0xmeowmeow/braidbench/social/industrial-poster.png

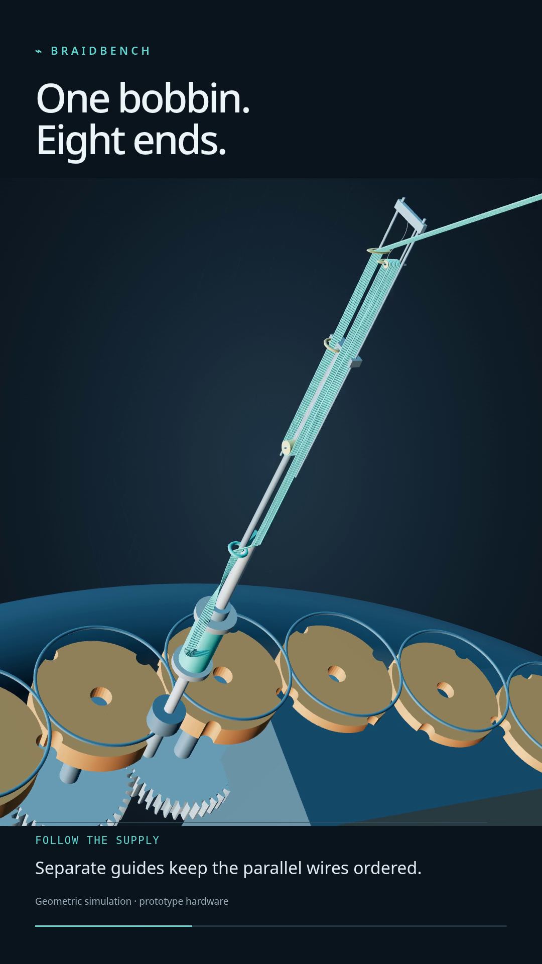
social/industrial-poster.png
