0xmeowmeow/braidbench/previews/braid-cutaway-72.png

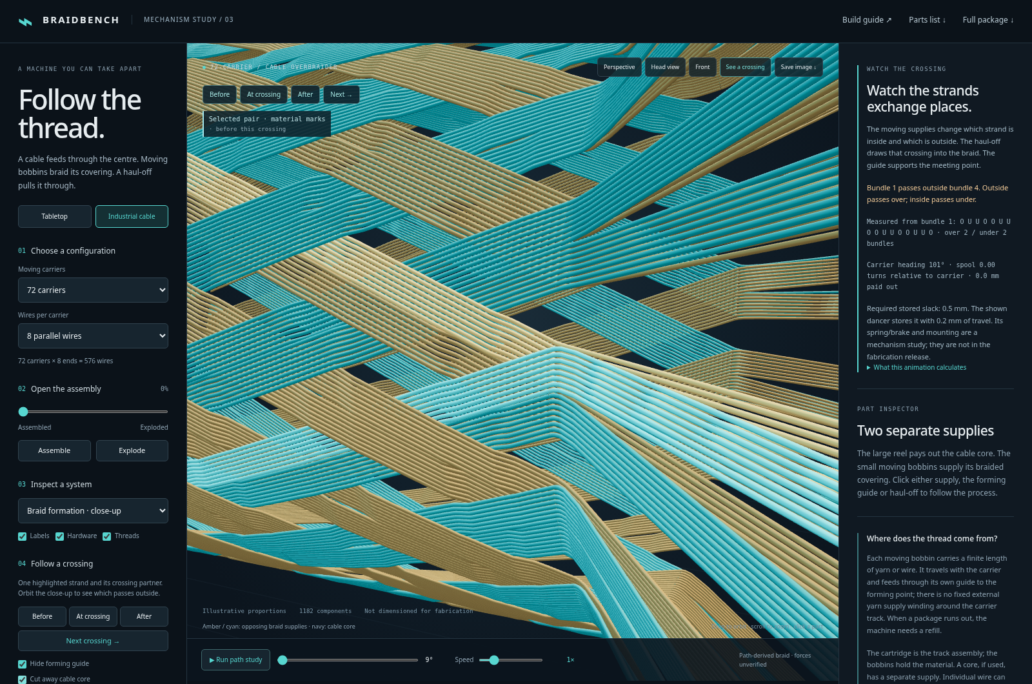
previews/braid-cutaway-72.png
