0xmeowmeow/braidbench/previews/bobbin-close-8.png

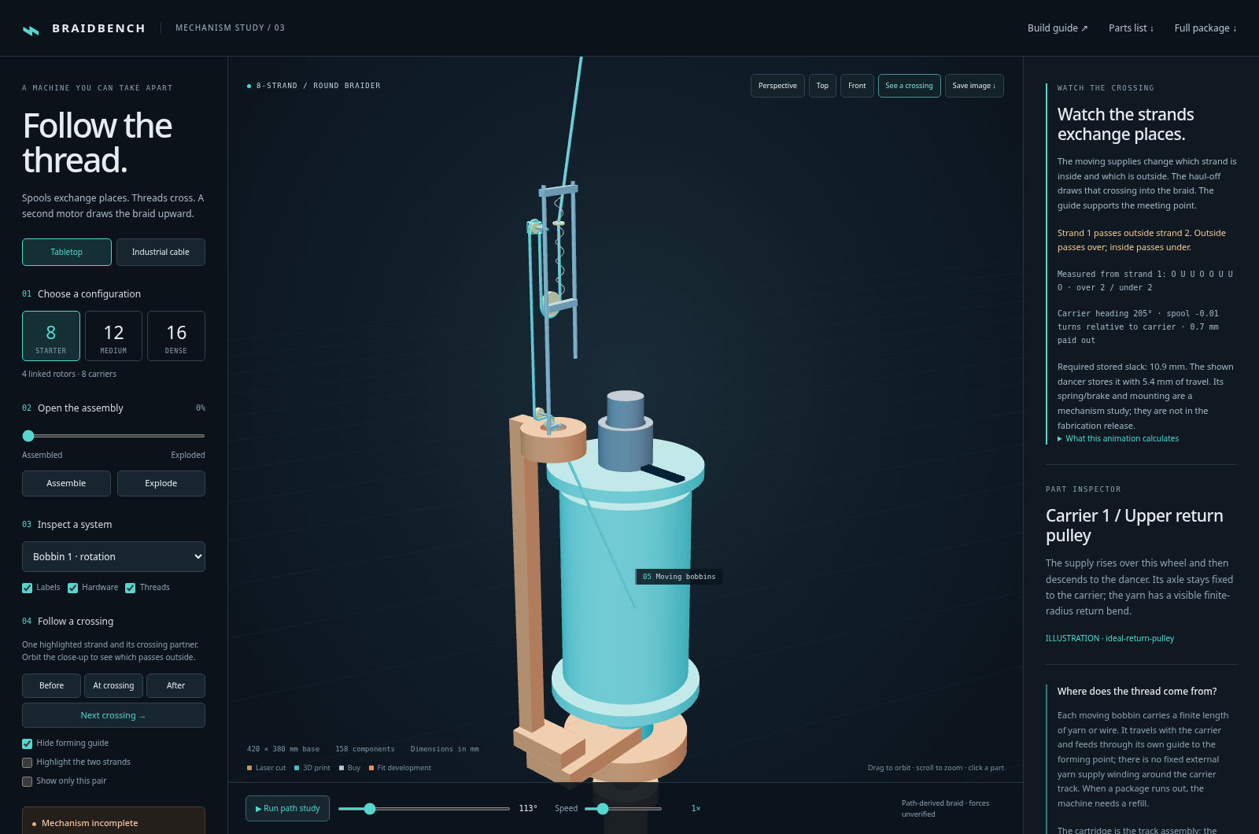
previews/bobbin-close-8.png
