0xmeowmeow/braidbench/previews/bobbin-close-16.png

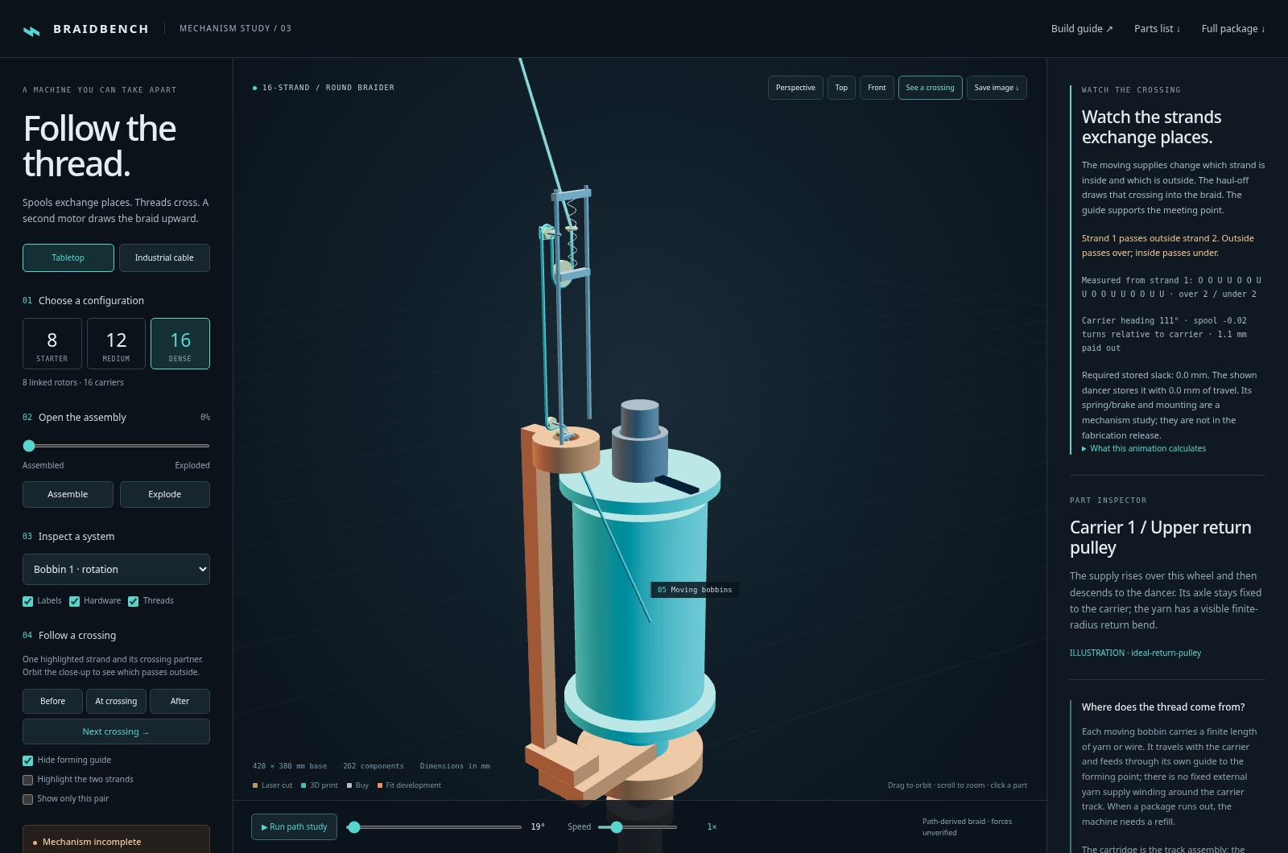
previews/bobbin-close-16.png
