0xmeowmeow/braidbench/previews/bobbin-close-48.png

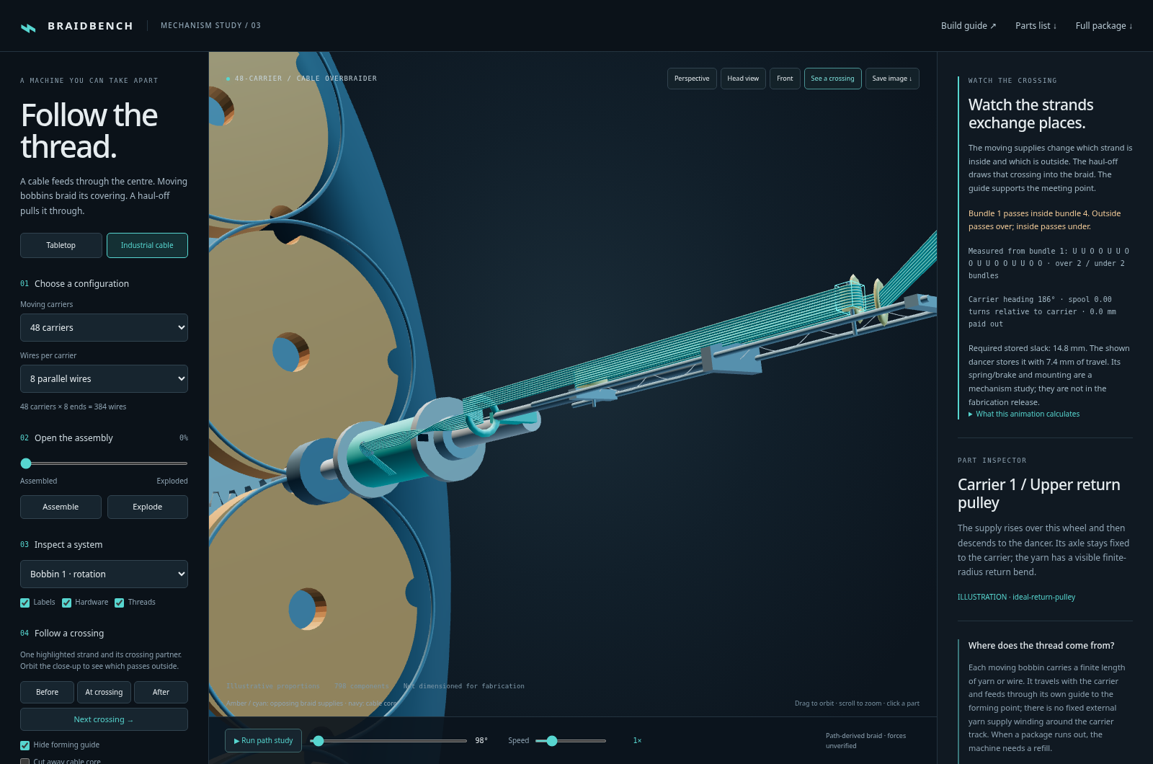
previews/bobbin-close-48.png
