0xmeowmeow/braidbench/previews/bobbin-close-72.png

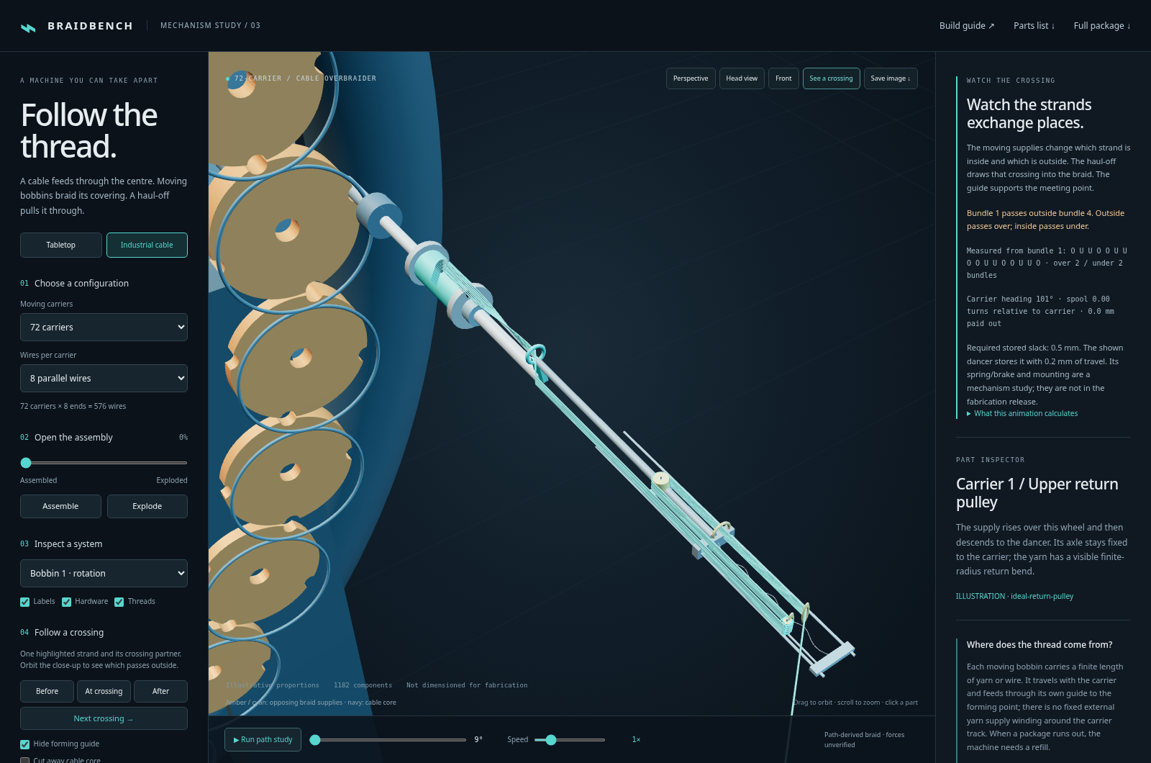
previews/bobbin-close-72.png
