0xmeowmeow/braidbench/previews/bobbin-tension.png

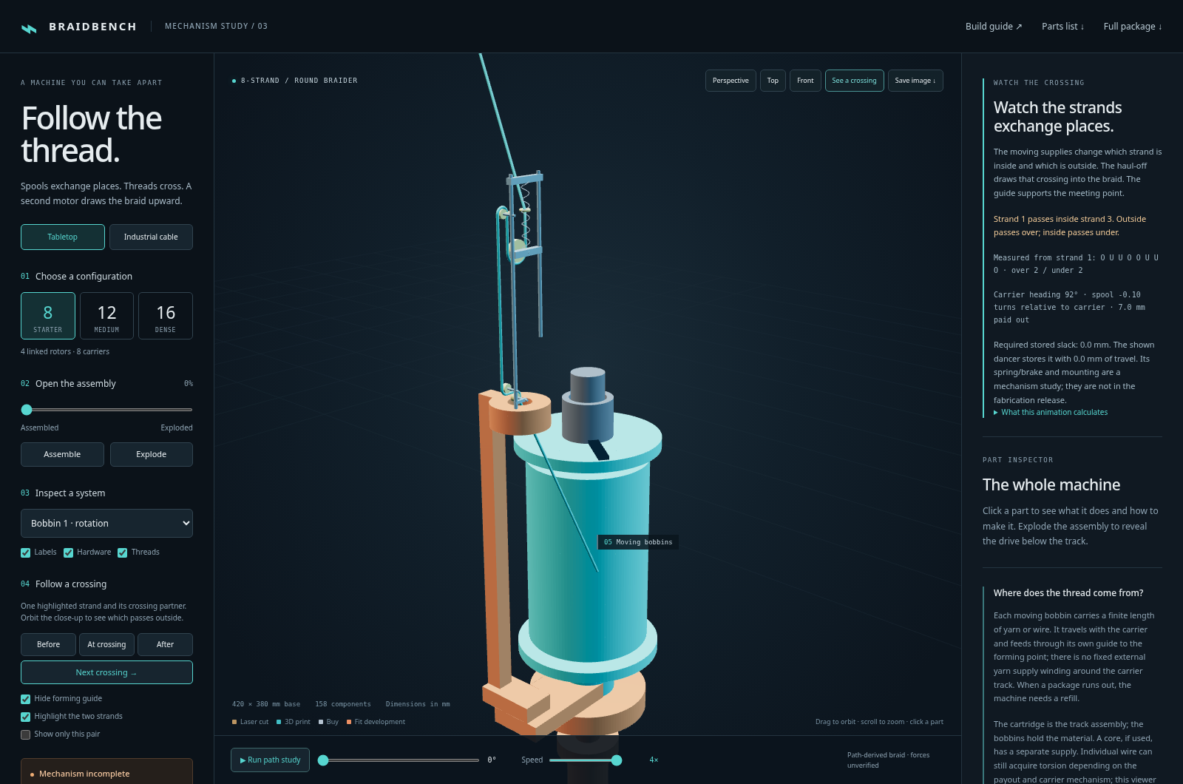
previews/bobbin-tension.png
