0xmeowmeow/braidbench/previews/braid-close-8.png

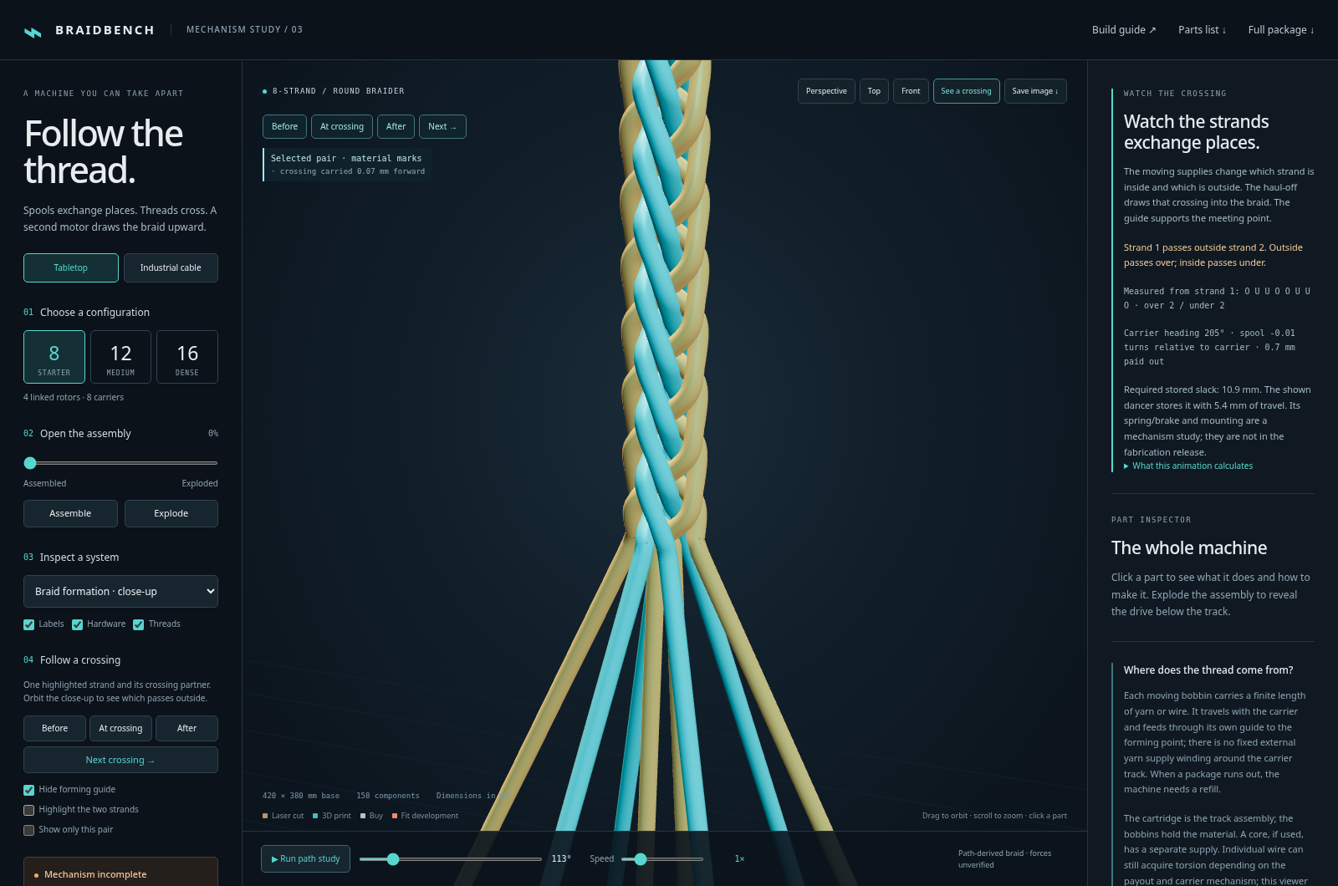
previews/braid-close-8.png
