0xmeowmeow/braidbench/previews/braid-close-16.png

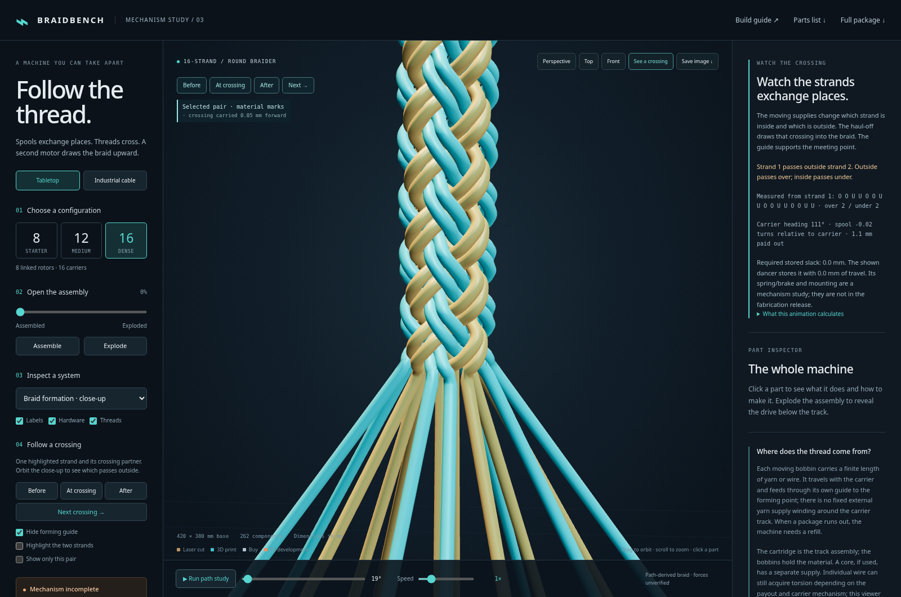
previews/braid-close-16.png
