0xmeowmeow/braidbench/previews/braid-close-48.png

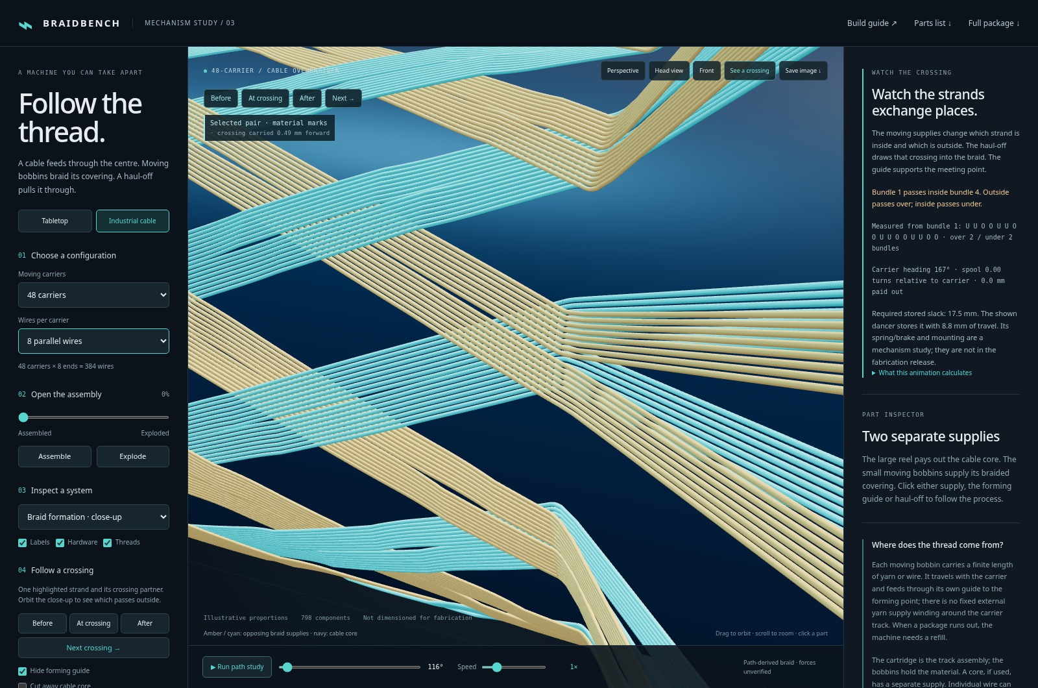
previews/braid-close-48.png
