0xmeowmeow/braidbench/previews/braid-close-72.png

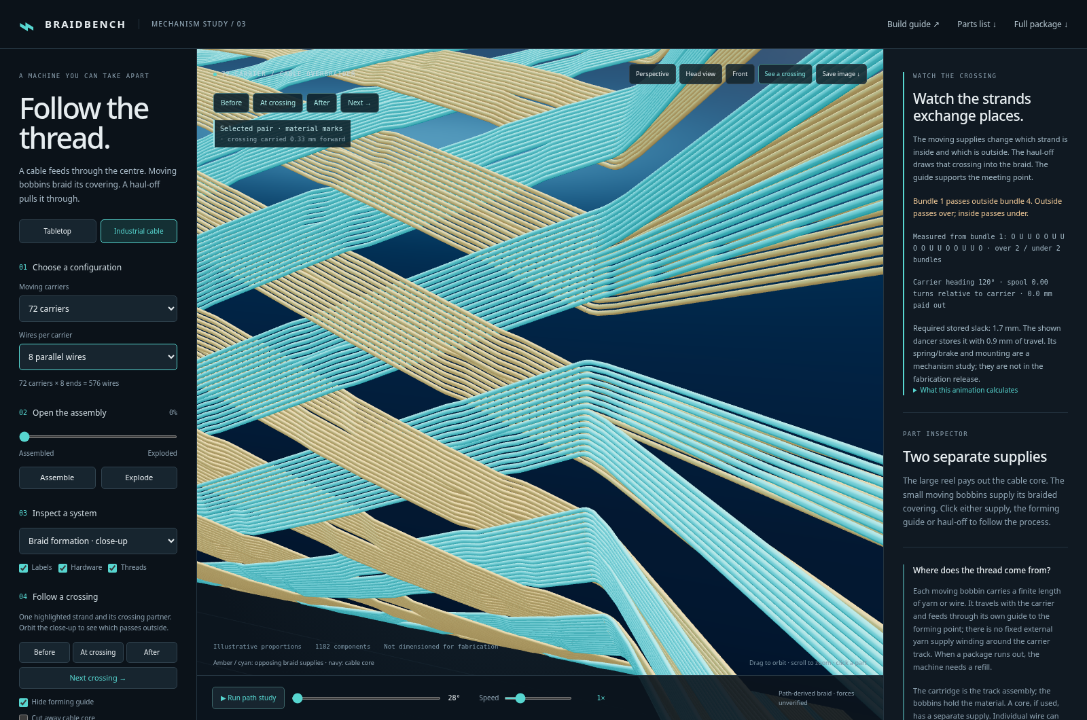
previews/braid-close-72.png
