0xmeowmeow/braidbench/previews/braid-cutaway-48.png

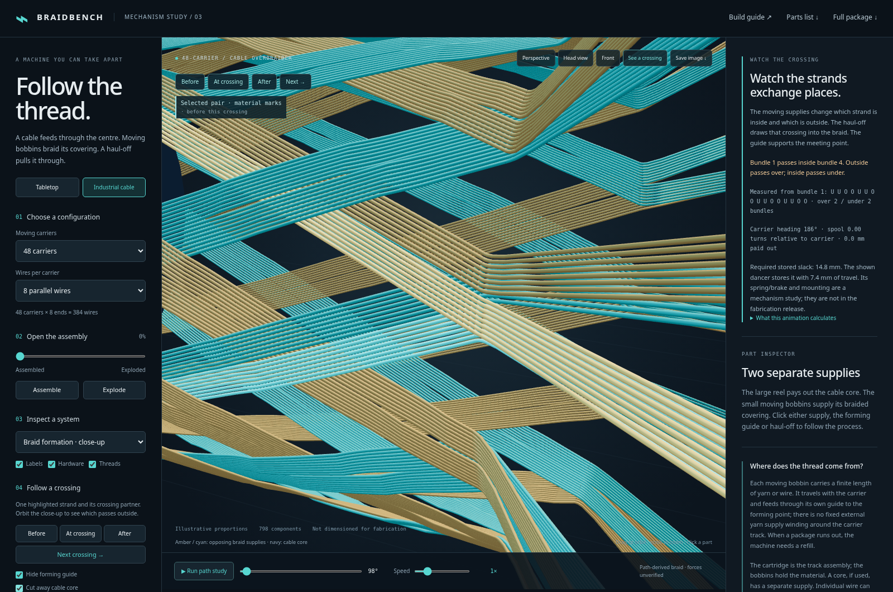
previews/braid-cutaway-48.png
