0xmeowmeow/braidbench/previews/drive.png

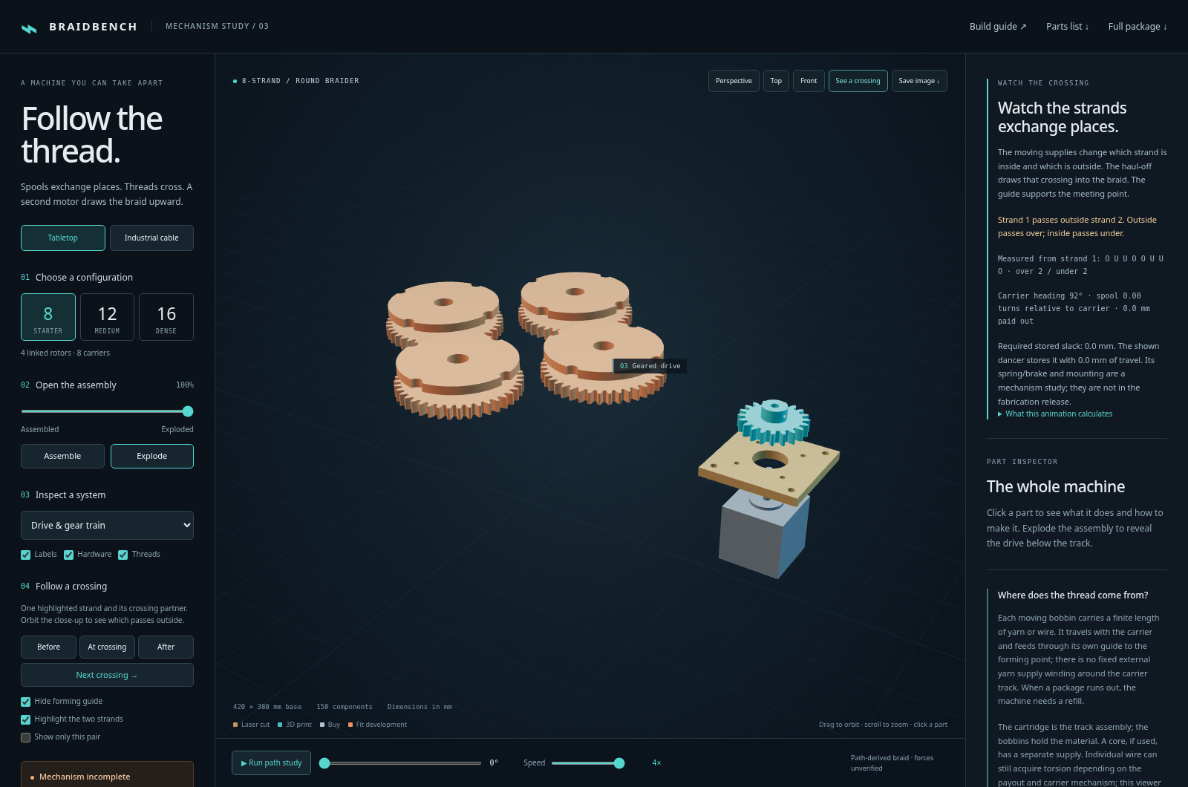
previews/drive.png
