0xmeowmeow/braidbench/previews/exploded.png

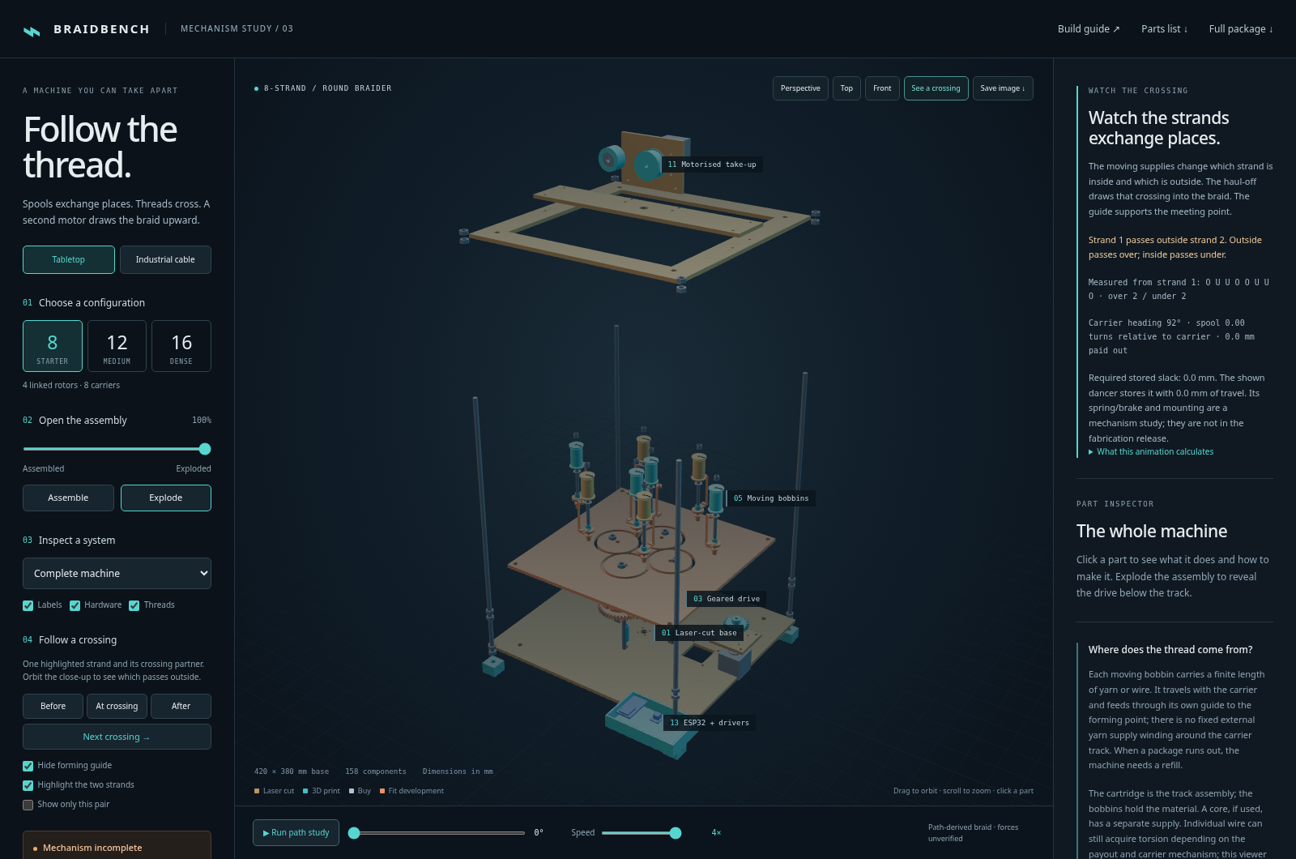
previews/exploded.png
