0xmeowmeow/braidbench/previews/formation-industrial-all.png

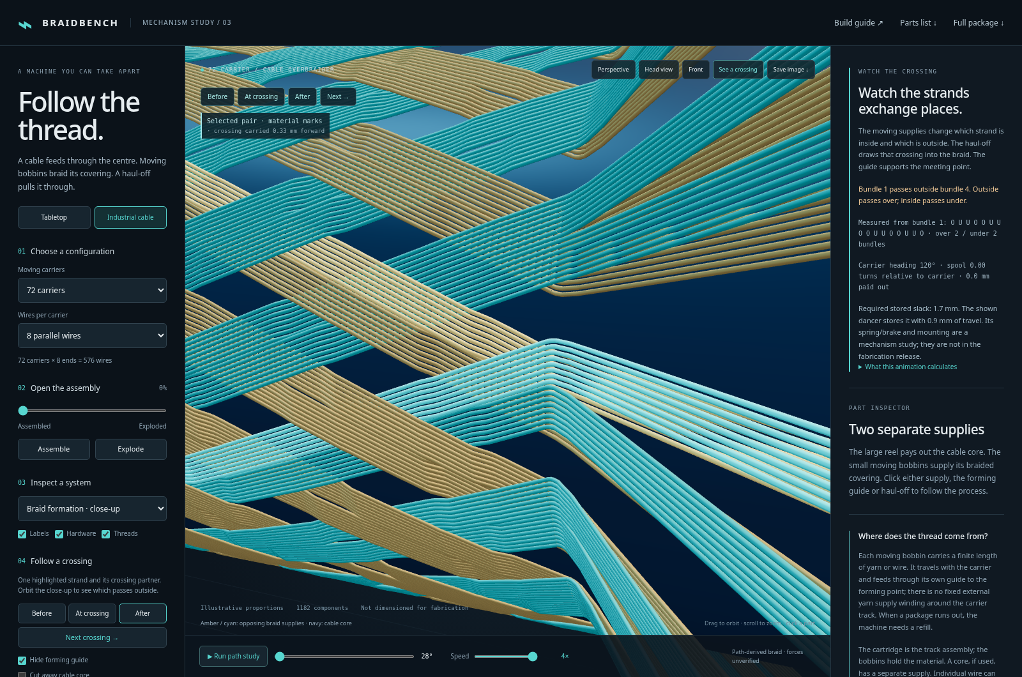
previews/formation-industrial-all.png
