0xmeowmeow/braidbench/previews/formation-industrial.png

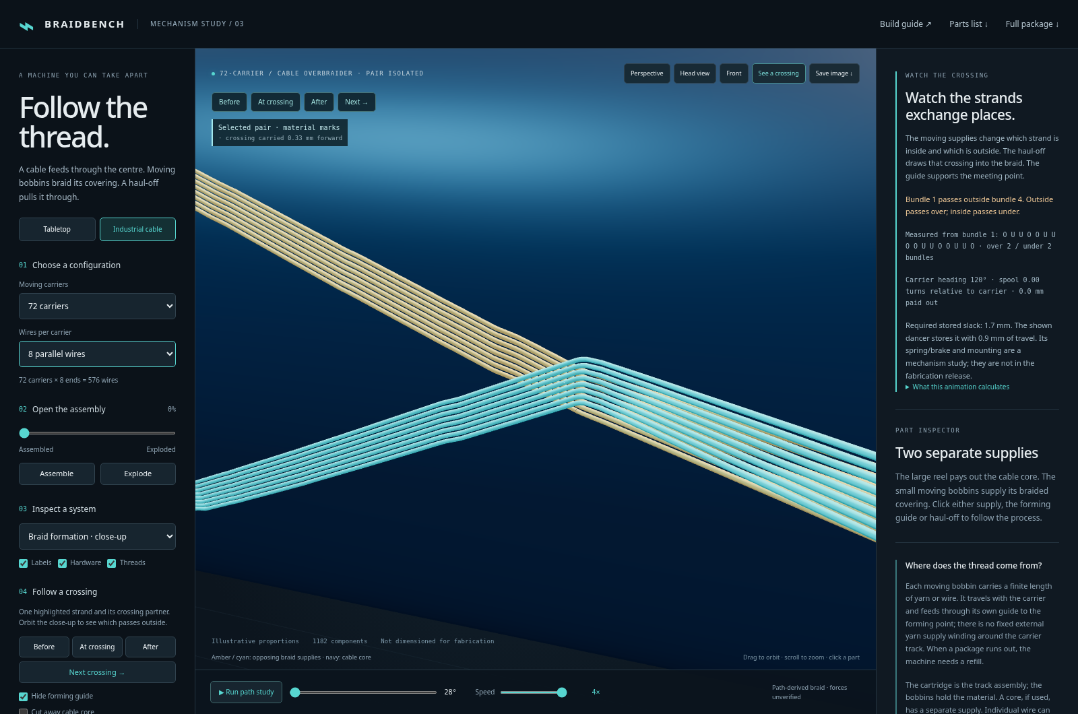
previews/formation-industrial.png
