0xmeowmeow/braidbench/previews/formation-mobile-320.png

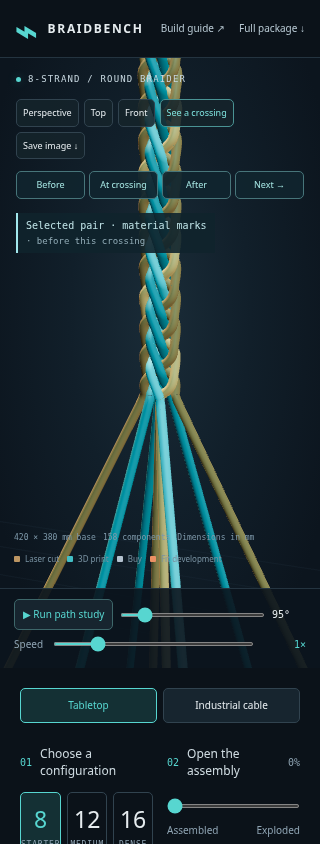
previews/formation-mobile-320.png
