0xmeowmeow/braidbench/previews/formation-mobile-390.png

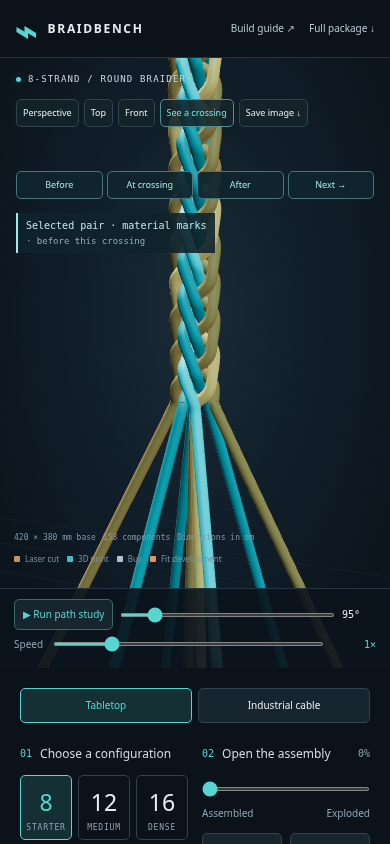
previews/formation-mobile-390.png
