0xmeowmeow/braidbench/previews/industrial-bobbin.png

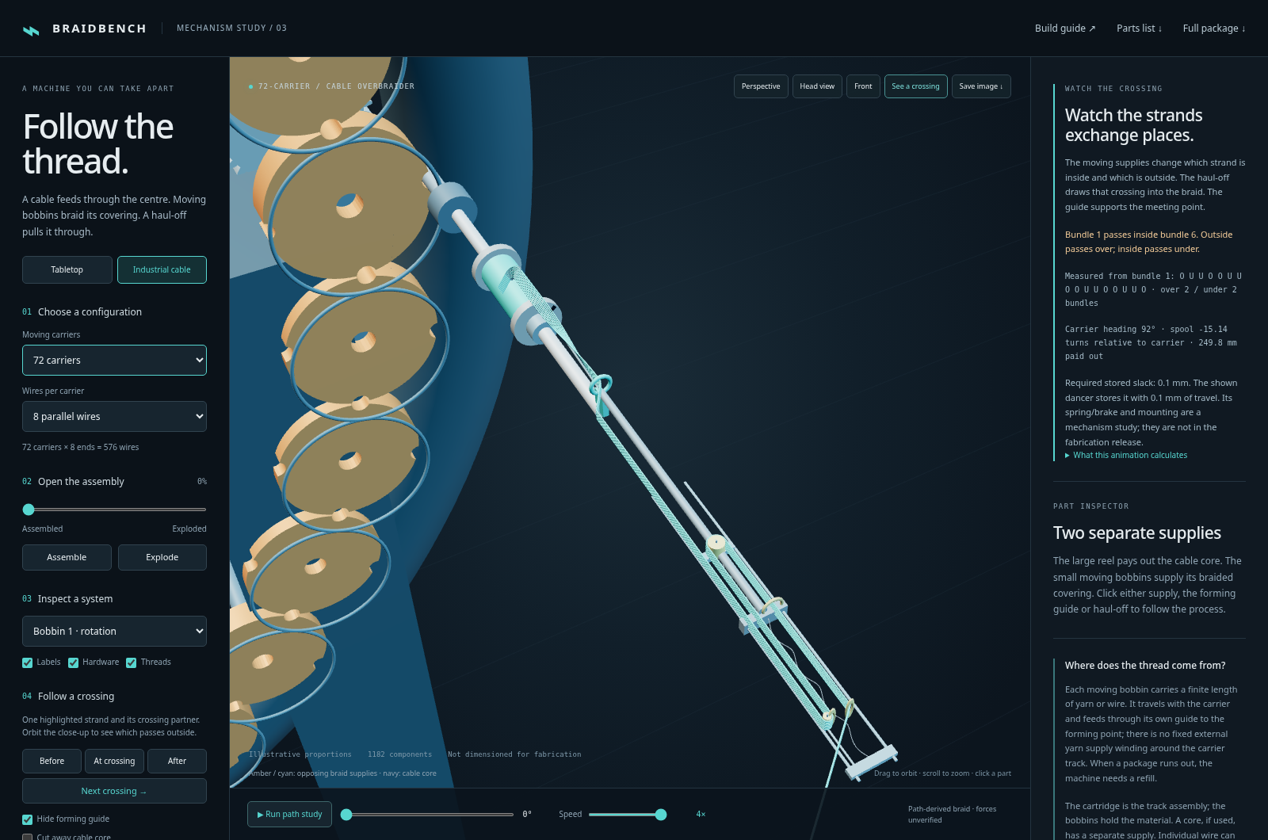
previews/industrial-bobbin.png
