0xmeowmeow/braidbench/previews/industrial-exploded.png

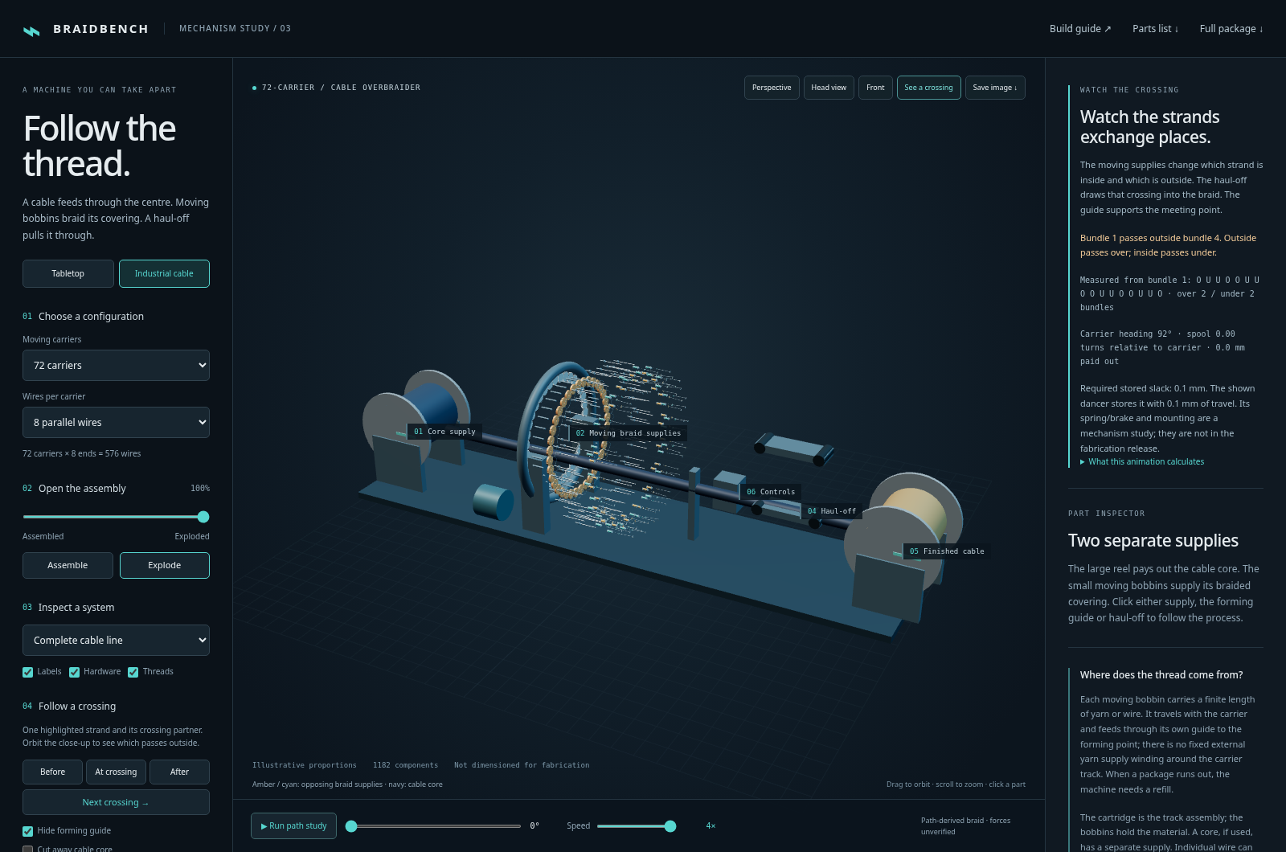
previews/industrial-exploded.png
