0xmeowmeow/braidbench/previews/industrial-head.png

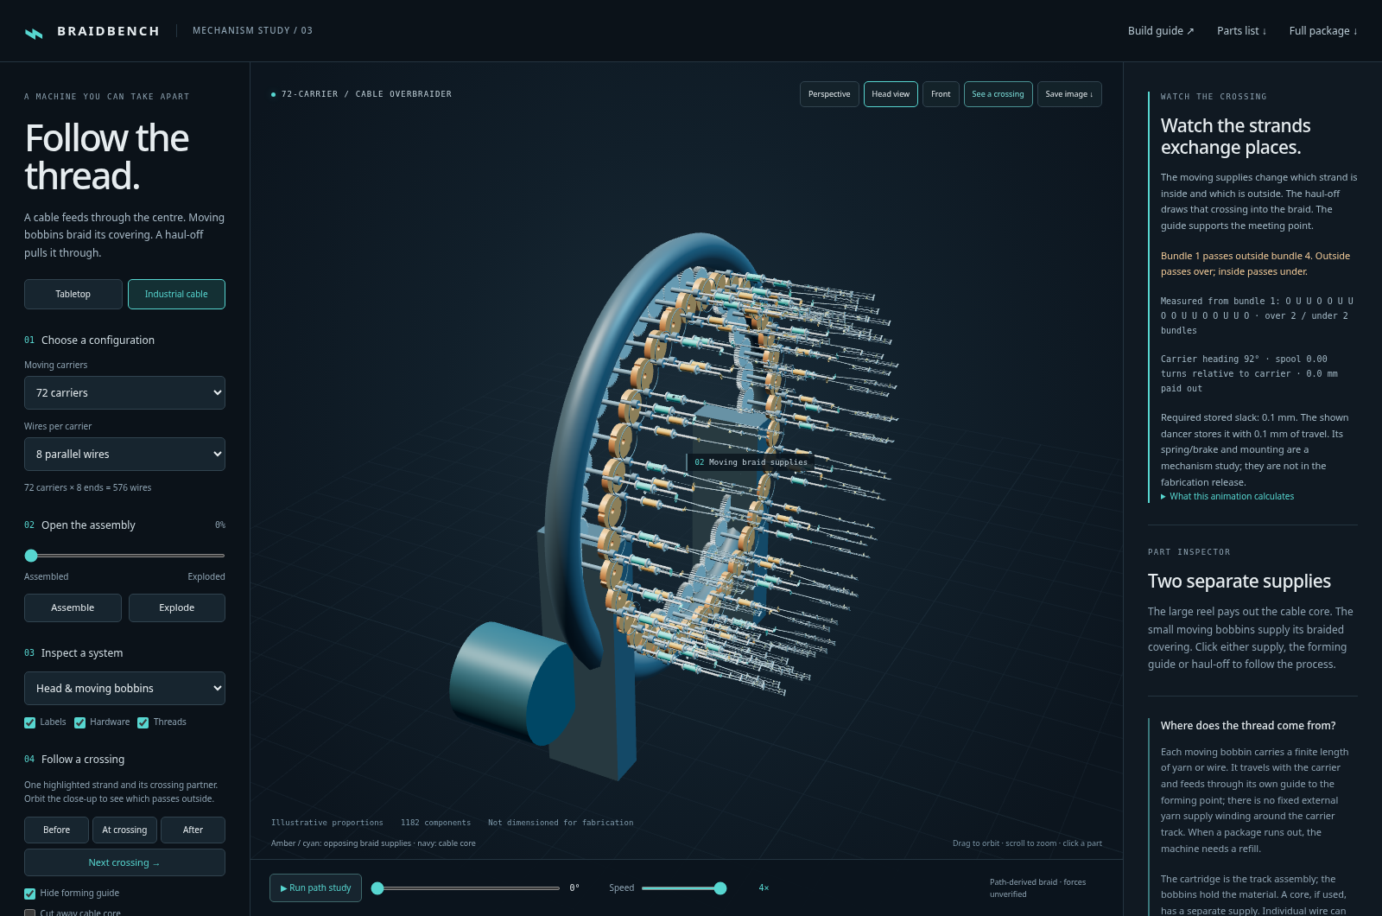
previews/industrial-head.png
