0xmeowmeow/braidbench/previews/industrial-mobile-320.png

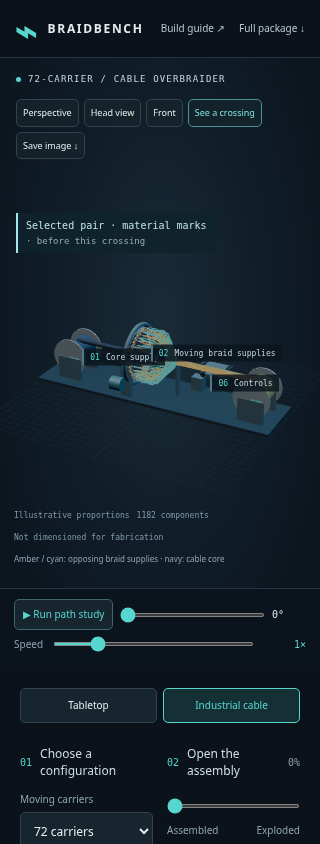
previews/industrial-mobile-320.png
