0xmeowmeow/braidbench/previews/industrial-mobile.png

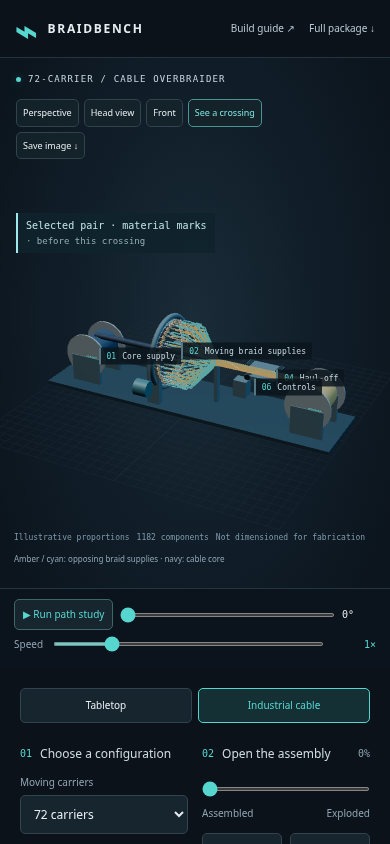
previews/industrial-mobile.png
