0xmeowmeow/braidbench/previews/industrial.png

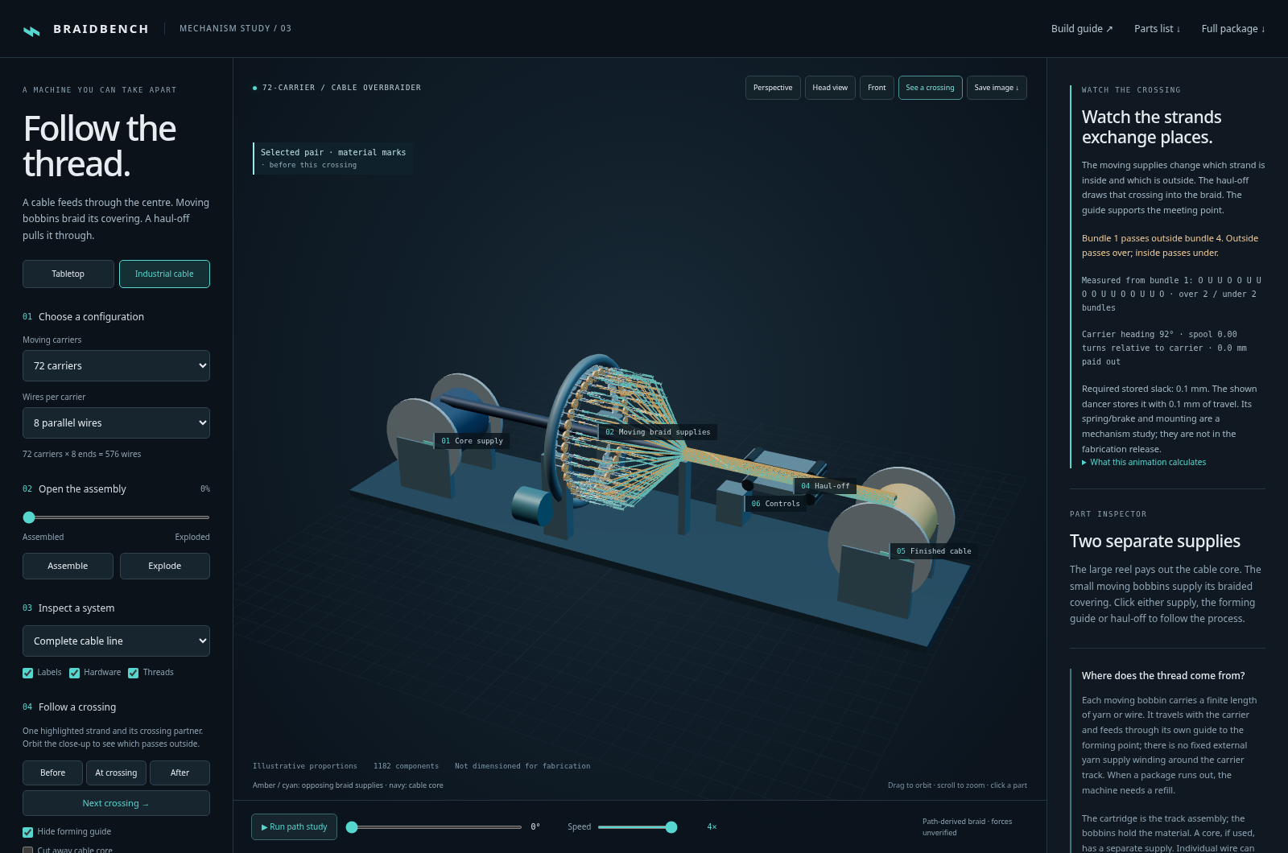
previews/industrial.png
