0xmeowmeow/braidbench/previews/mobile.png

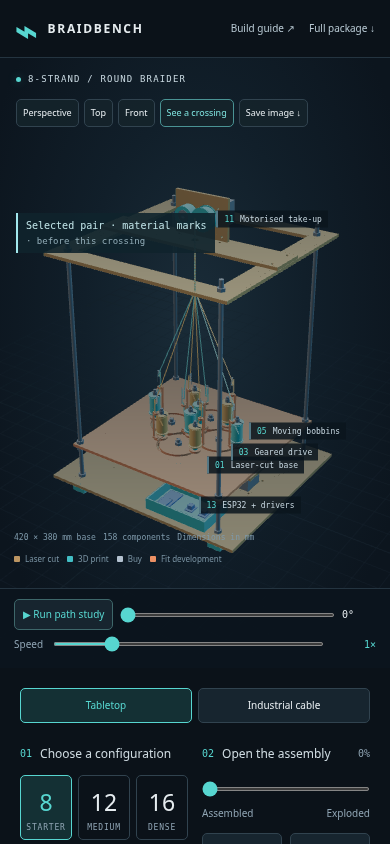
previews/mobile.png
