0xmeowmeow/braidbench/previews/publication-home-live.png

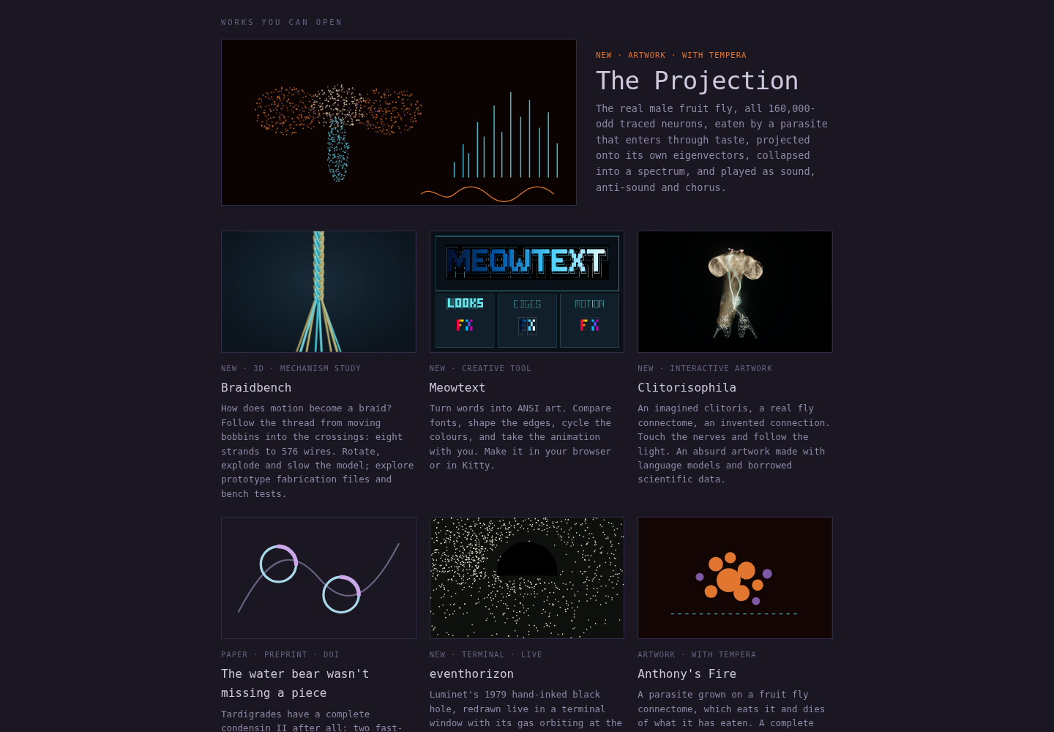
previews/publication-home-live.png
