0xmeowmeow/braidbench/previews/publication-home-mobile.png

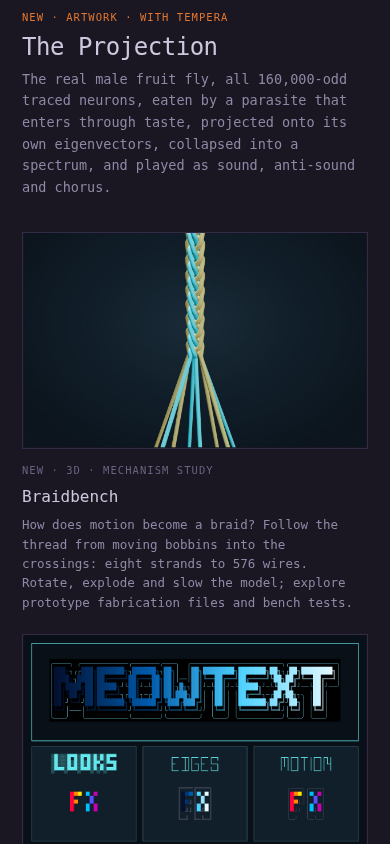
previews/publication-home-mobile.png
