0xmeowmeow/braidbench/previews/publication-model-live.png

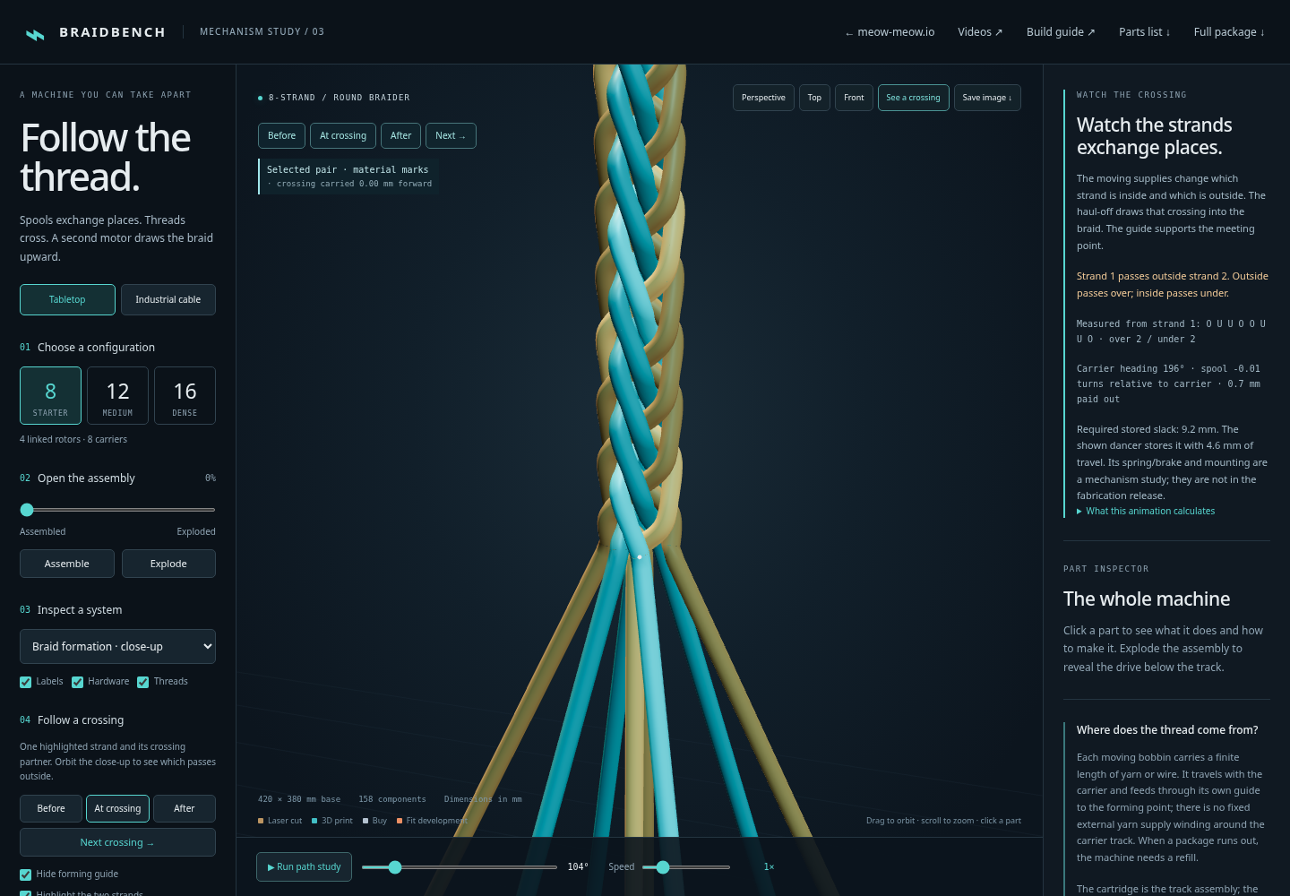
previews/publication-model-live.png
