0xmeowmeow/braidbench/previews/publication-videos-mobile.png

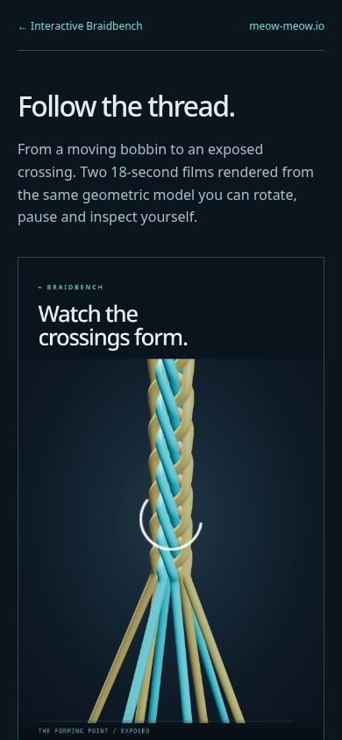
previews/publication-videos-mobile.png
