0xmeowmeow/braidbench/previews/tension-board.png

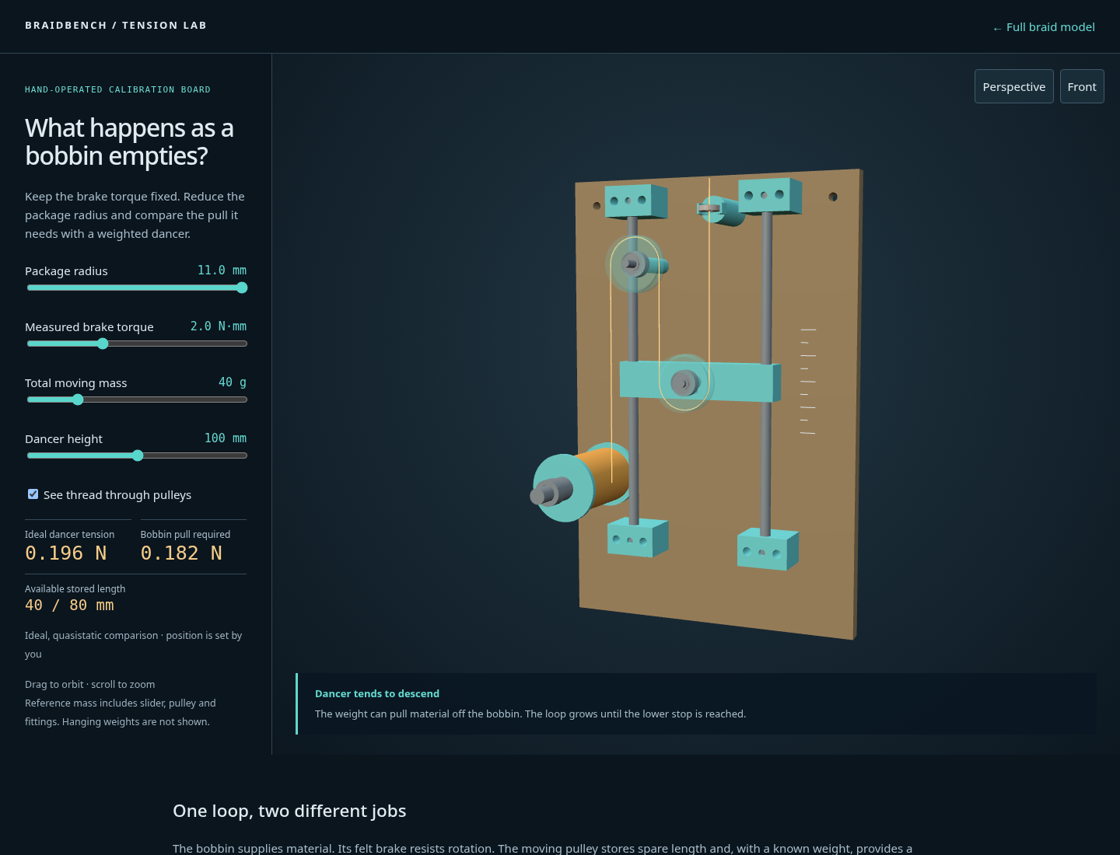
previews/tension-board.png
