0xmeowmeow/braidbench/previews/tension-mobile.png

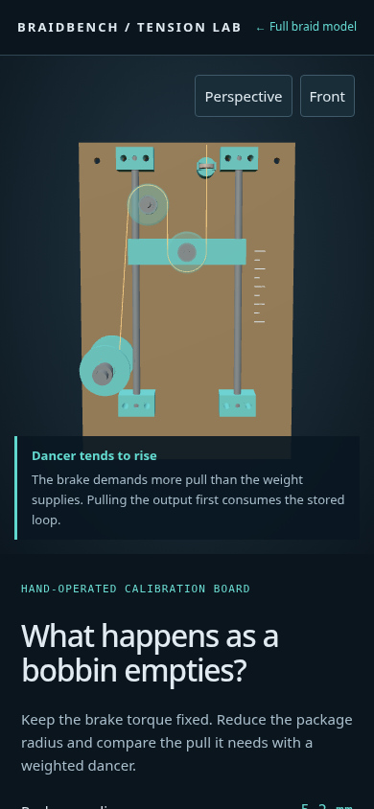
previews/tension-mobile.png
