0xmeowmeow/braidbench/previews/transfer-mobile.png

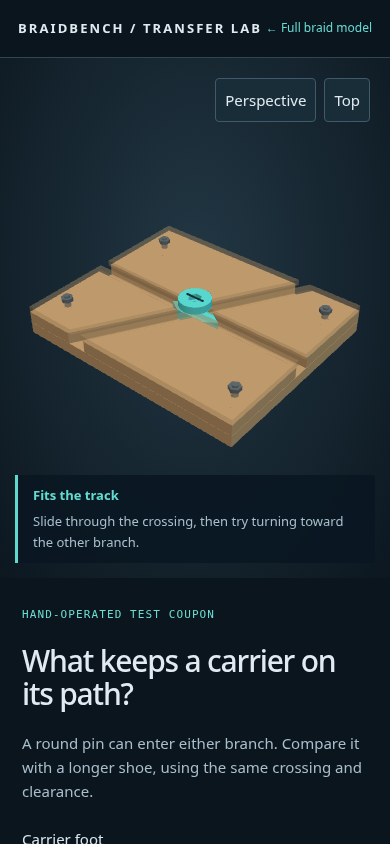
previews/transfer-mobile.png
