0xmeowmeow/braidbench/previews/transfer-round.png

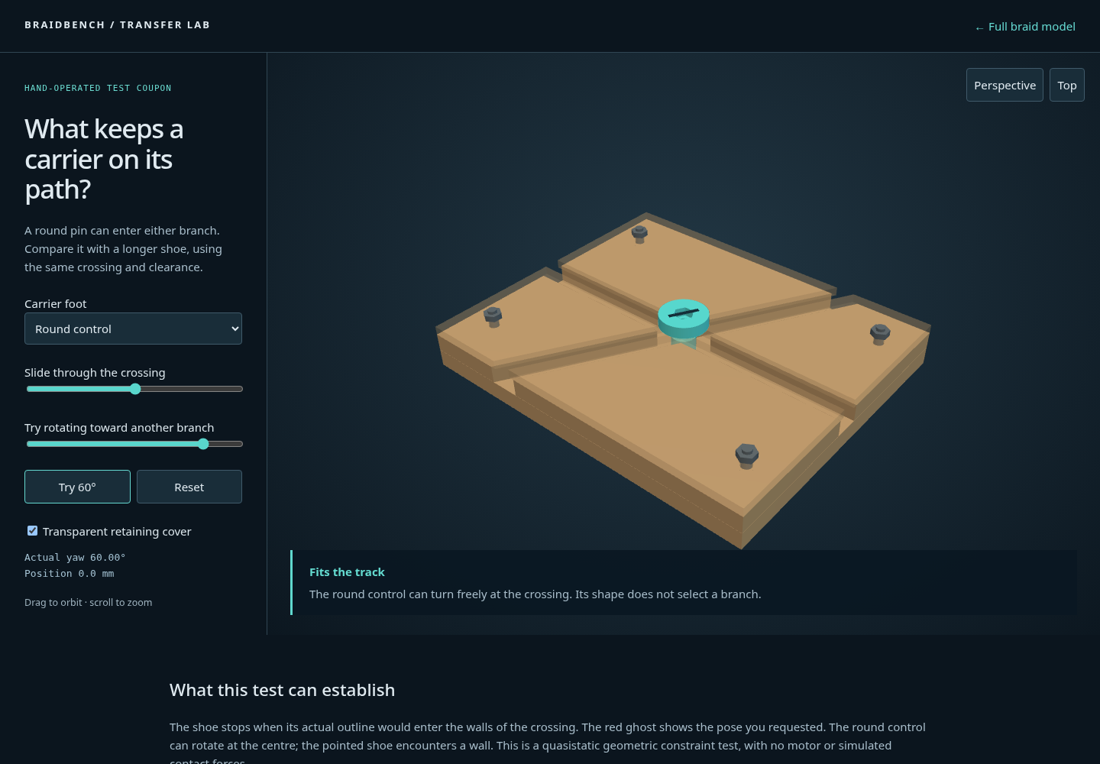
previews/transfer-round.png
