0xmeowmeow/braidbench/share/braidbench.jpg

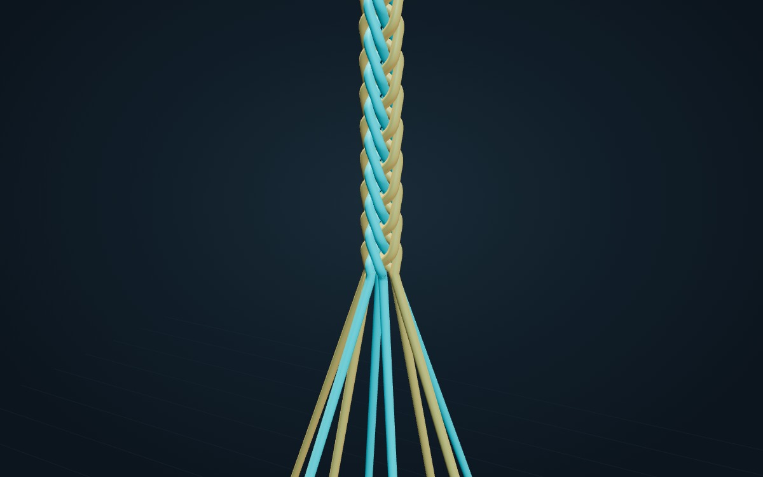
share/braidbench.jpg
