0xmeowmeow/braidbench/social/tabletop-poster.png

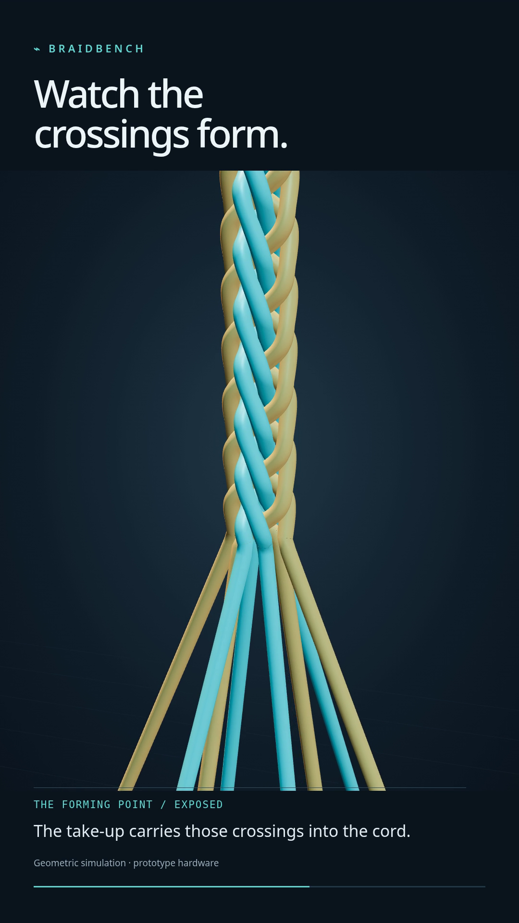
social/tabletop-poster.png
