0xmeowmeow/braidbench/fabrication/experiments/transfer/boat-shoe.step

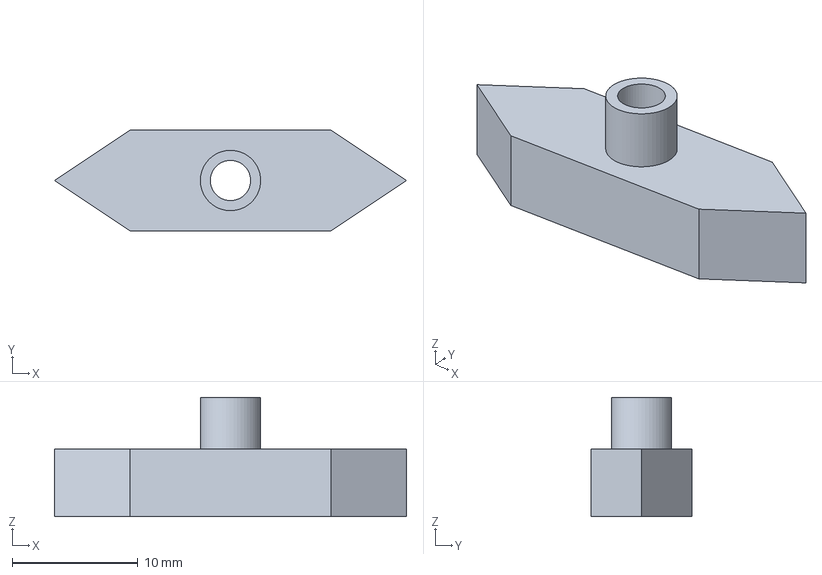
[picture p37: CAD file, 2026-10-12]
fabrication/experiments/transfer/boat-shoe.step
28.0 x 8.00 x 9.50 mm
