0xmeowmeow/braidbench/fabrication/laser/track-study-8.dxf

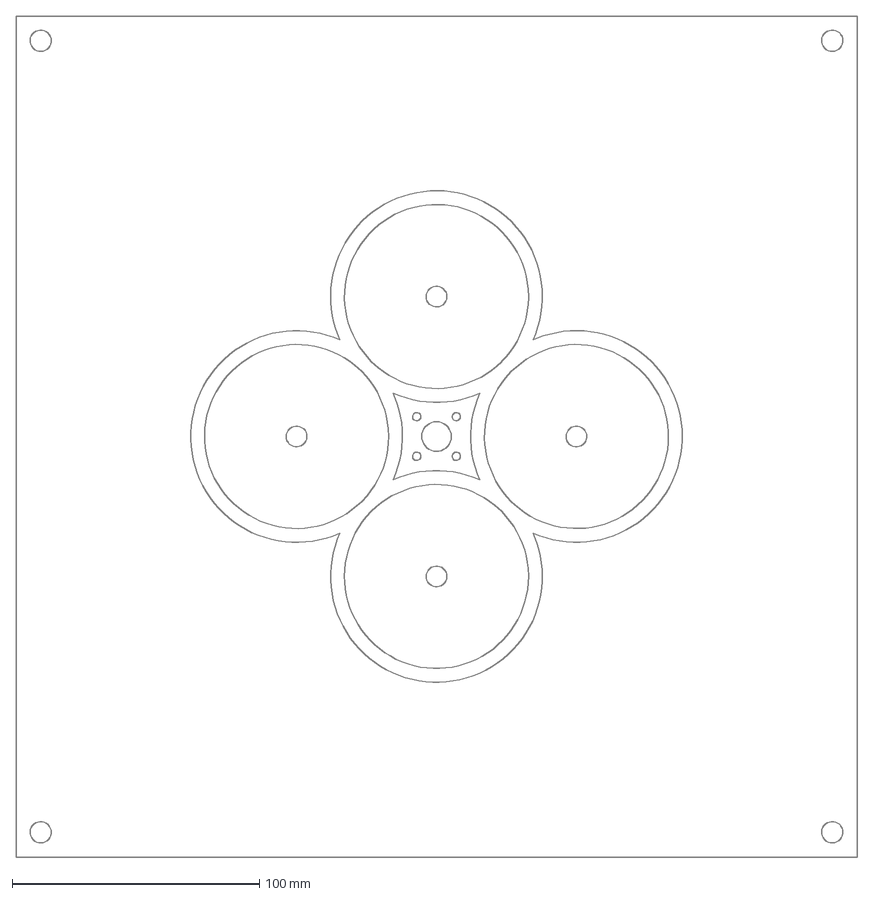
[picture p38: CAD file, 2026-10-12]
fabrication/laser/track-study-8.dxf
340.0 x 340.0 mm
