0xmeowmeow/braidbench/fabrication/printed/rotor-8-01.step

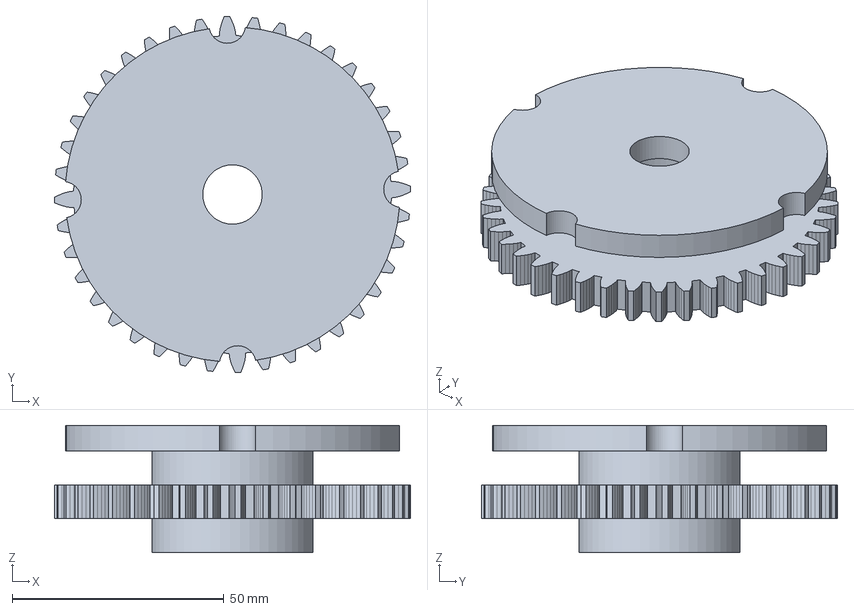
[picture p39: CAD file, 2026-10-12]
fabrication/printed/rotor-8-01.step
84.0 x 84.0 x 30.0 mm
