0xmeowmeow/braidbench/cad/braidbench-12.step

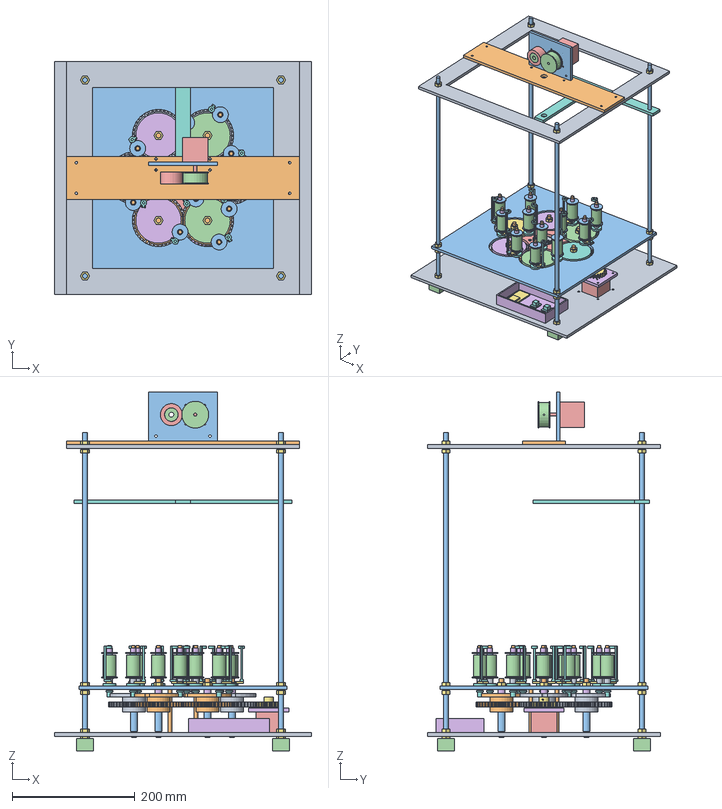
[picture p40: CAD file, 2026-10-12]
cad/braidbench-12.step
420.0 x 380.0 x 586.0 mm
