0xmeowmeow/braidbench/fabrication/experiments/tension/bobbin-base.step

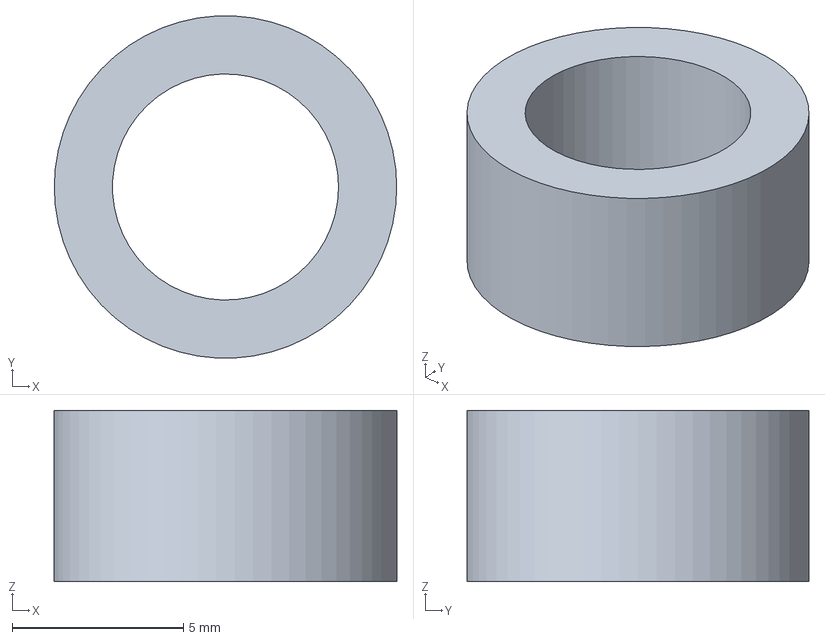
[picture p41: CAD file, 2026-10-12]
fabrication/experiments/tension/bobbin-base.step
10.0 x 9.99 x 5.00 mm
