0xmeowmeow/braidbench/fabrication/experiments/transfer/transfer-coupon.step

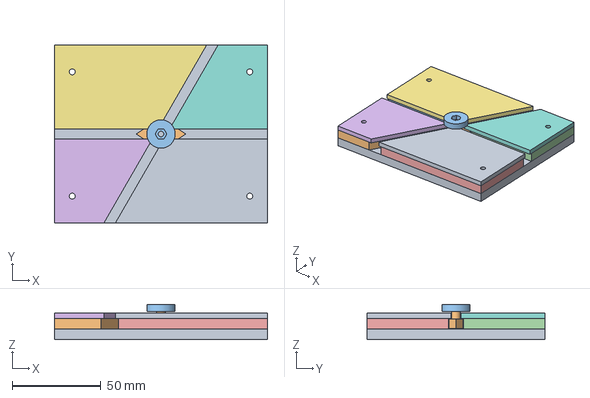
[picture p42: CAD file, 2026-10-12]
fabrication/experiments/transfer/transfer-coupon.step
120.0 x 100.0 x 19.8 mm
