0xmeowmeow/braidbench/fabrication/laser/takeup-face.dxf

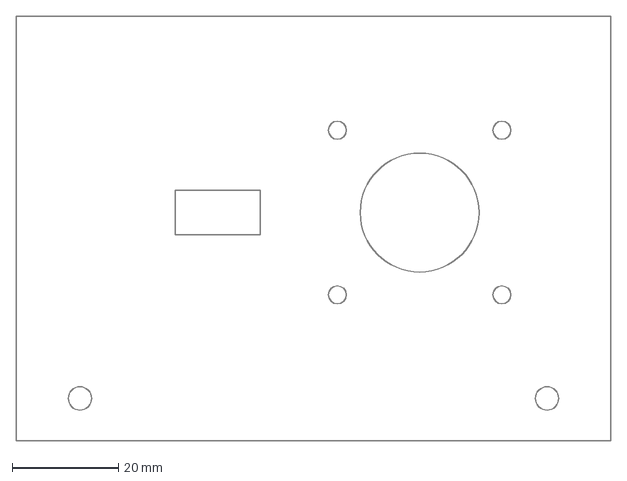
[picture p43: CAD file, 2026-10-12]
fabrication/laser/takeup-face.dxf
112.0 x 80.0 mm
