0xmeowmeow/braidbench/fabrication/experiments/tension/bench-bobbin.step

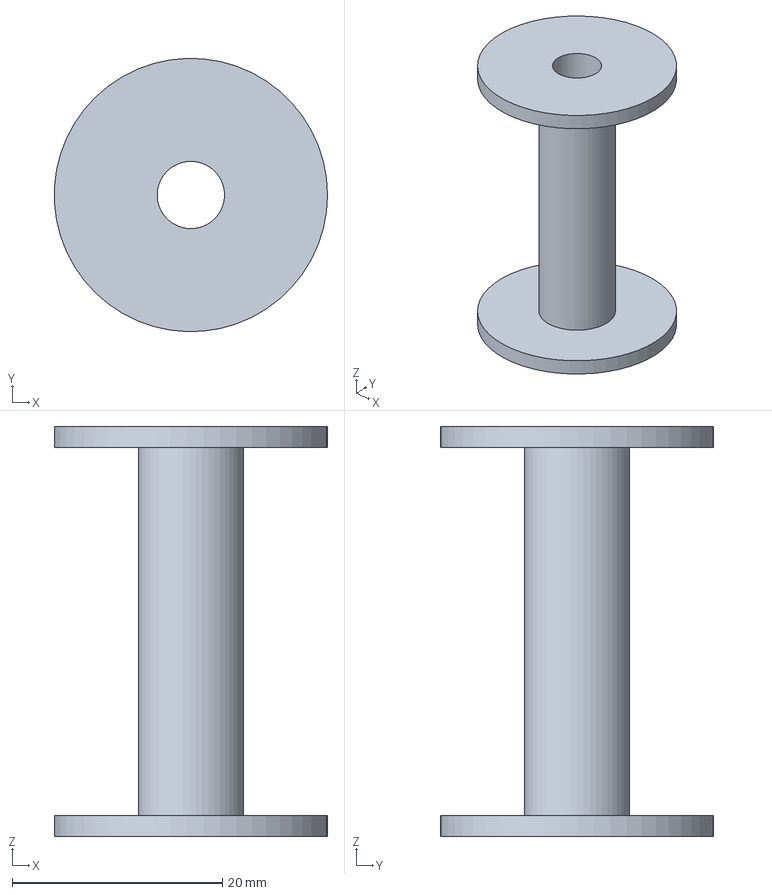
[picture p45: CAD file, 2026-10-12]
fabrication/experiments/tension/bench-bobbin.step
26.0 x 26.0 x 39.0 mm
