0xmeowmeow/braidbench/fabrication/experiments/transfer/track.step

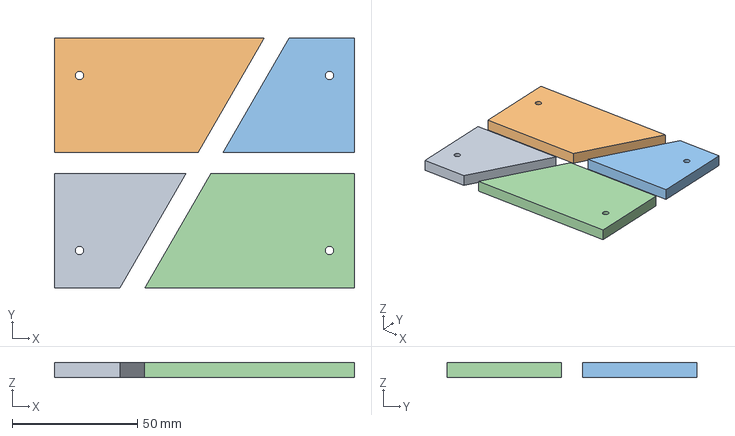
[picture p46: CAD file, 2026-10-12]
fabrication/experiments/transfer/track.step
120.0 x 100.0 x 6.00 mm
