0xmeowmeow/braidbench/fabrication/laser/motor-riser.dxf

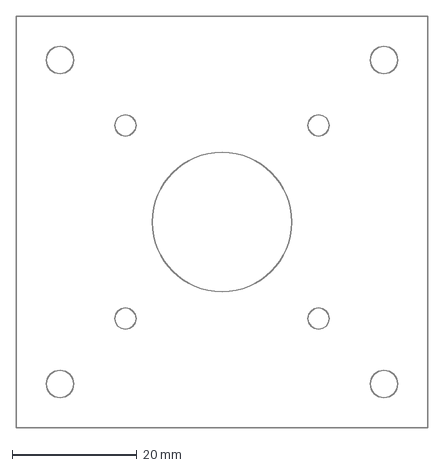
[picture p47: CAD file, 2026-10-12]
fabrication/laser/motor-riser.dxf
66.0 x 66.0 mm
