0xmeowmeow/braidbench/fabrication/experiments/tension/tension-board.step

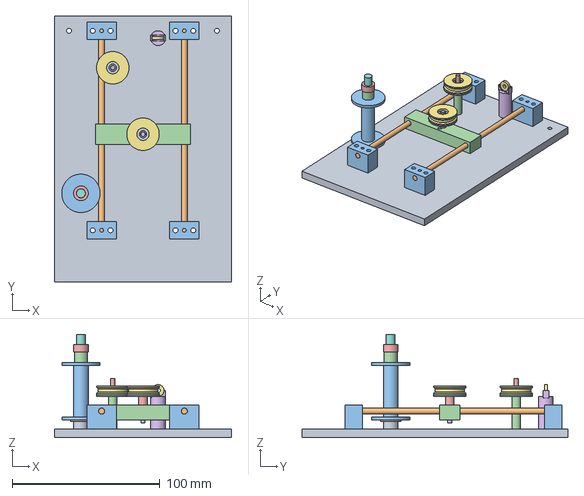
[picture p48: CAD file, 2026-10-12]
fabrication/experiments/tension/tension-board.step
120.0 x 180.0 x 70.0 mm
