0xmeowmeow/braidbench/fabrication/experiments/transfer/base.step

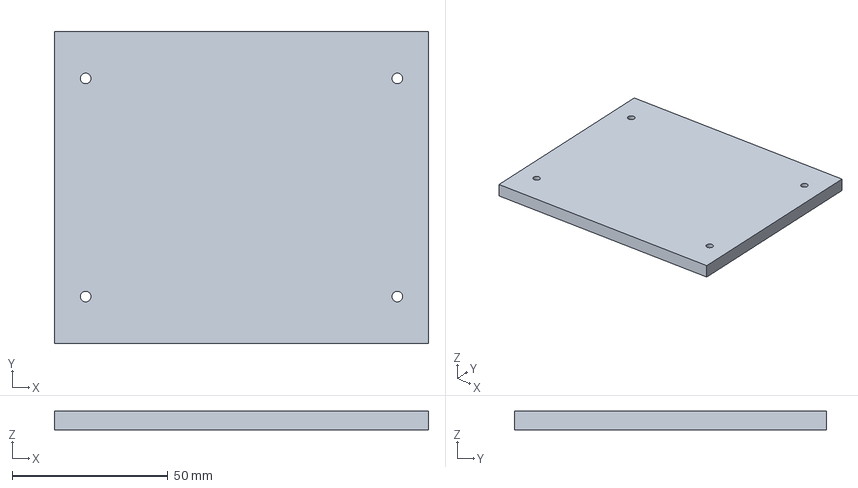
[picture p49: CAD file, 2026-10-12]
fabrication/experiments/transfer/base.step
120.0 x 100.0 x 6.00 mm
