0xmeowmeow/braidbench/fabrication/laser/base-12.dxf

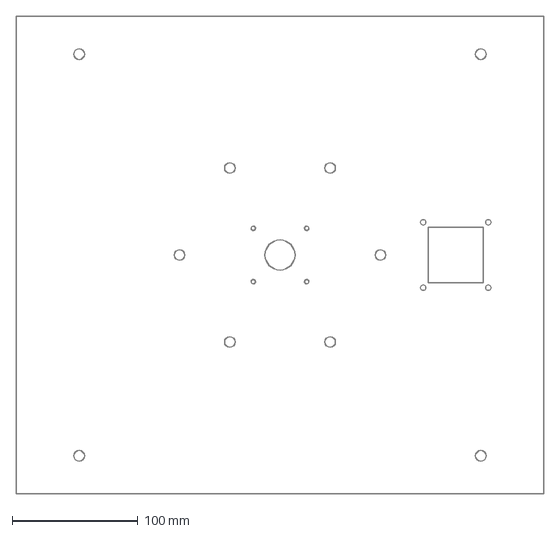
[picture p50: CAD file, 2026-10-12]
fabrication/laser/base-12.dxf
420.0 x 380.0 mm
