0xmeowmeow/braidbench/fabrication/printed/foot.step

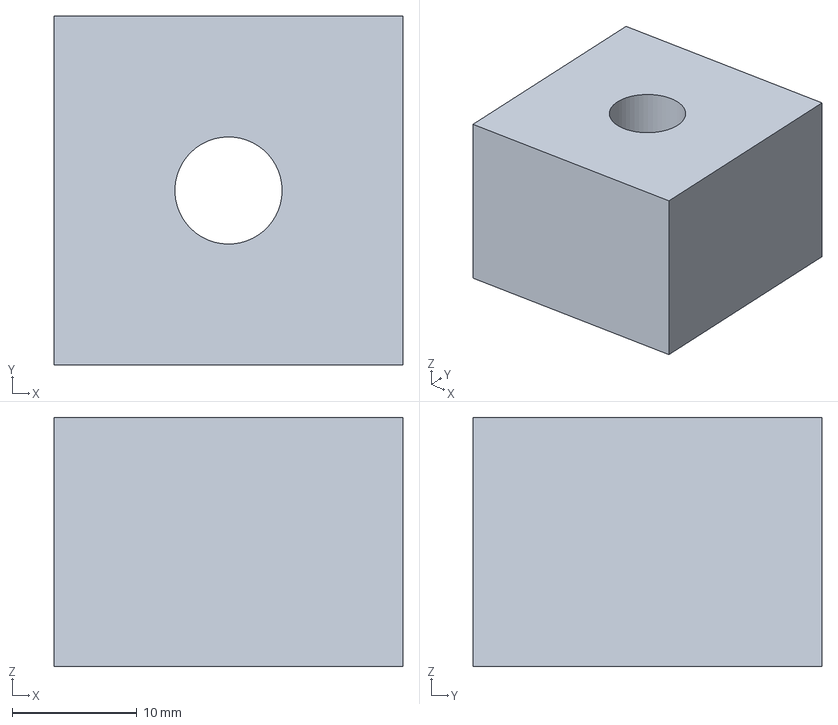
[picture p51: CAD file, 2026-10-12]
fabrication/printed/foot.step
28.0 x 28.0 x 20.0 mm
