0xmeowmeow/braidbench/fabrication/experiments/tension/M3-fixed-axle.step

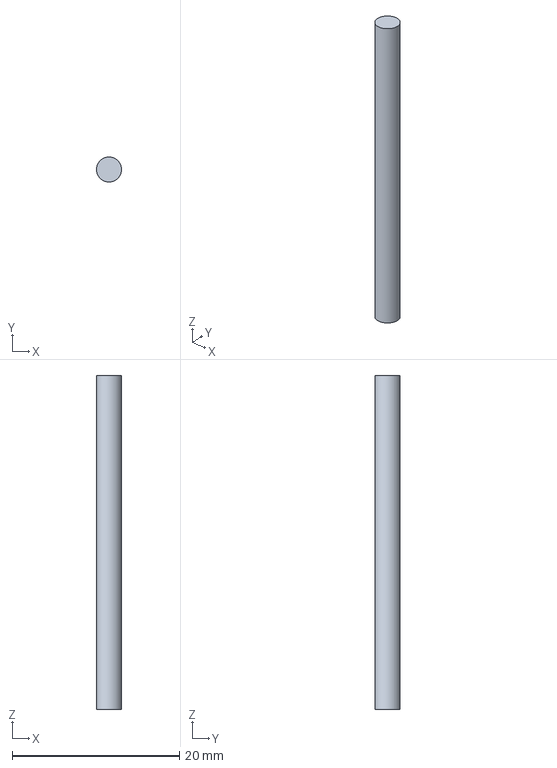
[picture p52: CAD file, 2026-10-12]
fabrication/experiments/tension/M3-fixed-axle.step
3.00 x 3.00 x 40.0 mm
