0xmeowmeow/braidbench/fabrication/experiments/transfer/handle.step

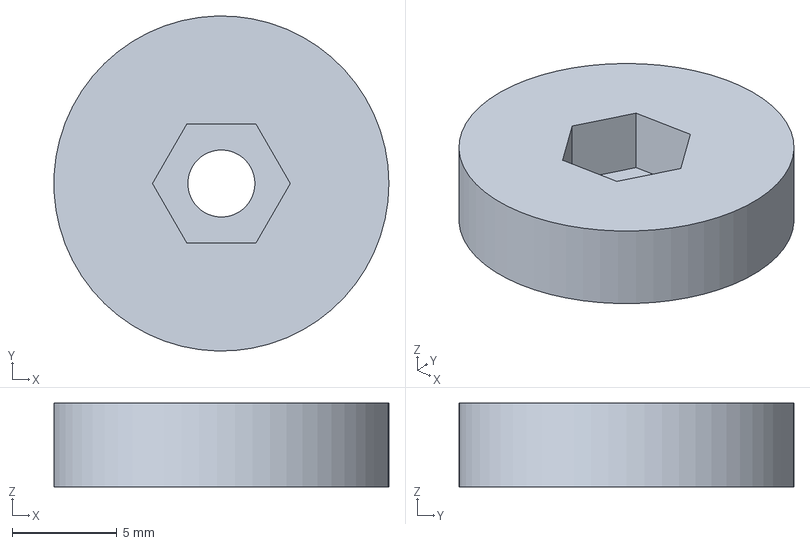
[picture p53: CAD file, 2026-10-12]
fabrication/experiments/transfer/handle.step
16.0 x 16.0 x 4.00 mm
