0xmeowmeow/braidbench/fabrication/laser/base-8.dxf

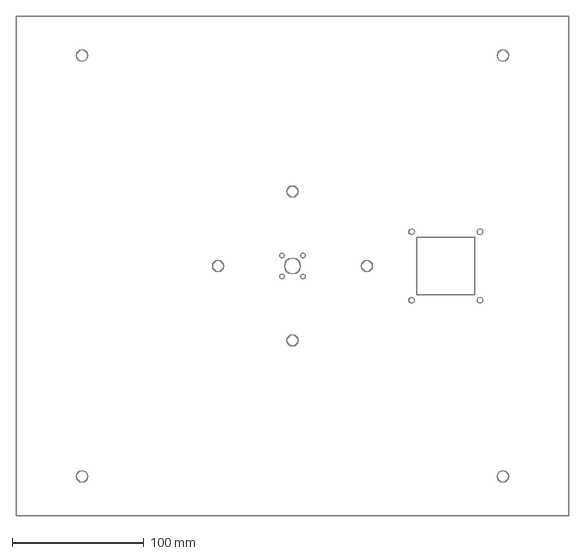
[picture p54: CAD file, 2026-10-12]
fabrication/laser/base-8.dxf
420.0 x 380.0 mm
