0xmeowmeow/braidbench/fabrication/experiments/tension/inner-race-shim.step

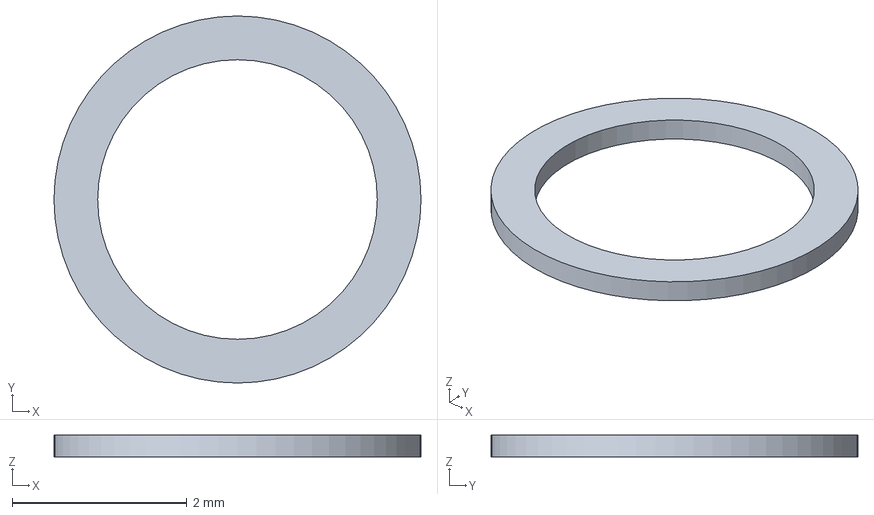
[picture p55: CAD file, 2026-10-12]
fabrication/experiments/tension/inner-race-shim.step
4.20 x 4.20 x 0.25 mm
