0xmeowmeow/braidbench/fabrication/experiments/transfer/cover.step

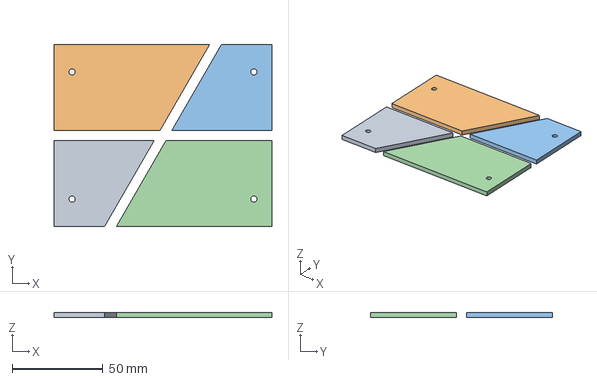
[picture p56: CAD file, 2026-10-12]
fabrication/experiments/transfer/cover.step
120.0 x 100.0 x 3.00 mm
