0xmeowmeow/braidbench/fabrication/laser/upper-frame.dxf

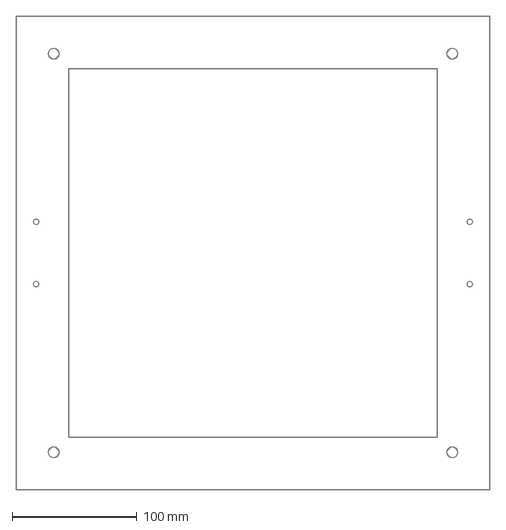
[picture p57: CAD file, 2026-10-12]
fabrication/laser/upper-frame.dxf
380.0 x 380.0 mm
