0xmeowmeow/braidbench/fabrication/printed/bobbin.step

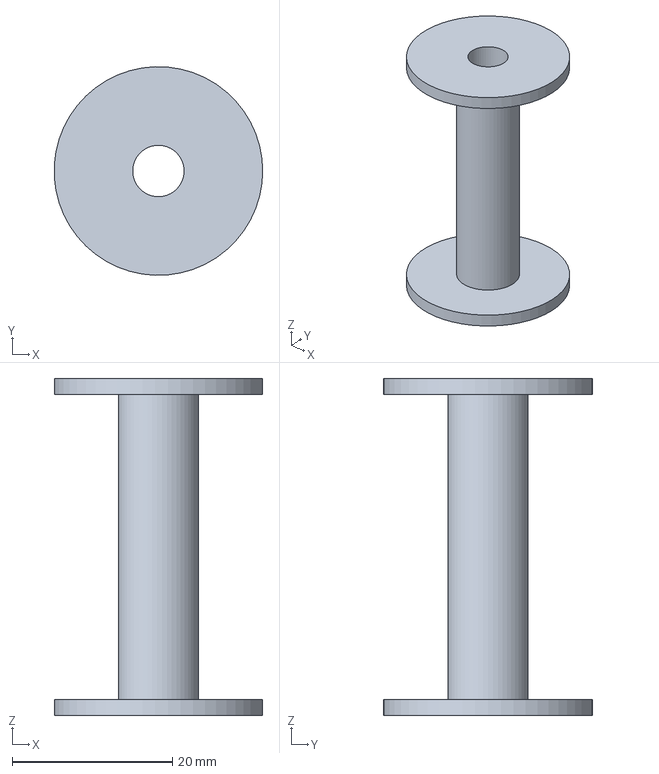
[picture p58: CAD file, 2026-10-12]
fabrication/printed/bobbin.step
26.0 x 26.0 x 42.0 mm
