0xmeowmeow/braidbench/fabrication/experiments/tension/eye-holder.step

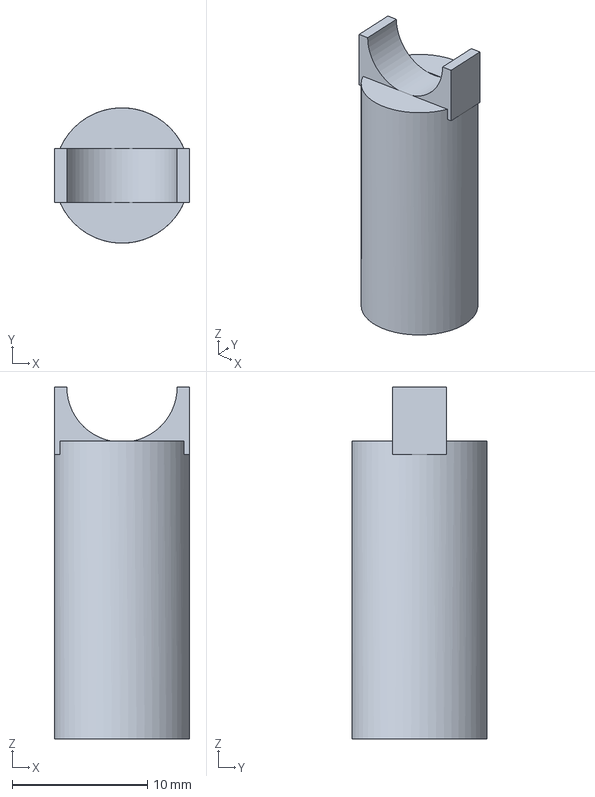
[picture p59: CAD file, 2026-10-12]
fabrication/experiments/tension/eye-holder.step
10.0 x 10.00 x 26.0 mm
