0xmeowmeow/braidbench/fabrication/experiments/transfer/round-shoe.step

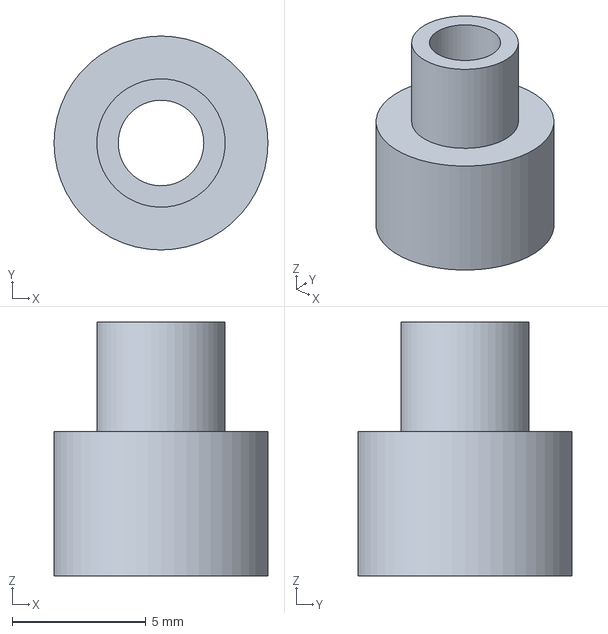
[picture p60: CAD file, 2026-10-12]
fabrication/experiments/transfer/round-shoe.step
8.00 x 8.00 x 9.50 mm
