0xmeowmeow/braidbench/fabrication/laser/fit-coupon.dxf

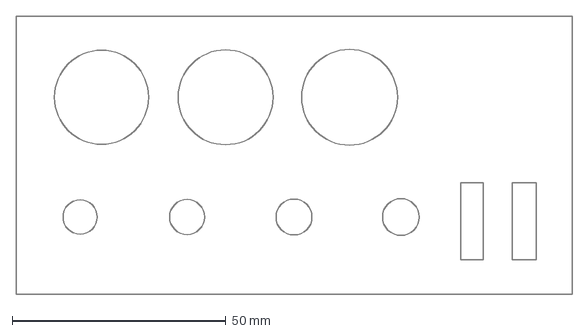
[picture p61: CAD file, 2026-10-12]
fabrication/laser/fit-coupon.dxf
130.0 x 65.0 mm
