0xmeowmeow/braidbench/fabrication/printed/spindle-adapter.step

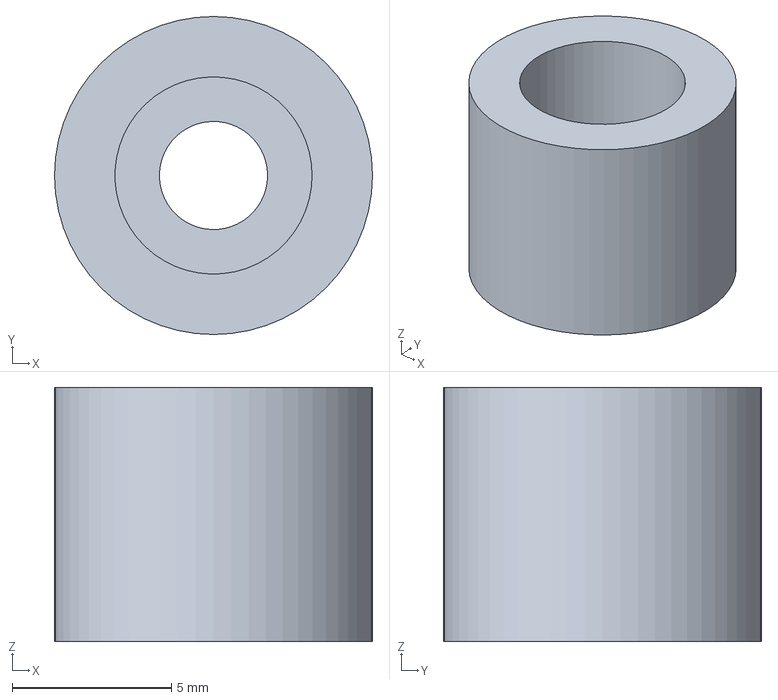
[picture p62: CAD file, 2026-10-12]
fabrication/printed/spindle-adapter.step
10.0 x 10.0 x 8.00 mm
