0xmeowmeow/braidbench/fabrication/laser/forming-guide.dxf

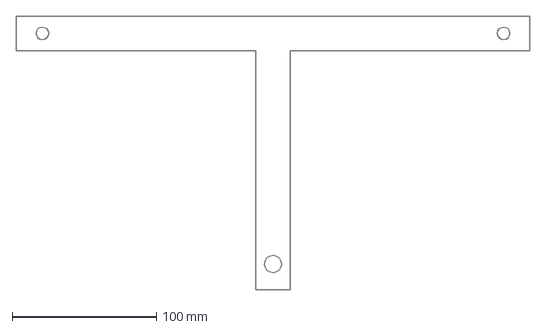
[picture p63: CAD file, 2026-10-12]
fabrication/laser/forming-guide.dxf
356.0 x 190.0 mm
