0xmeowmeow/braidbench/fabrication/printed/carrier-body.step

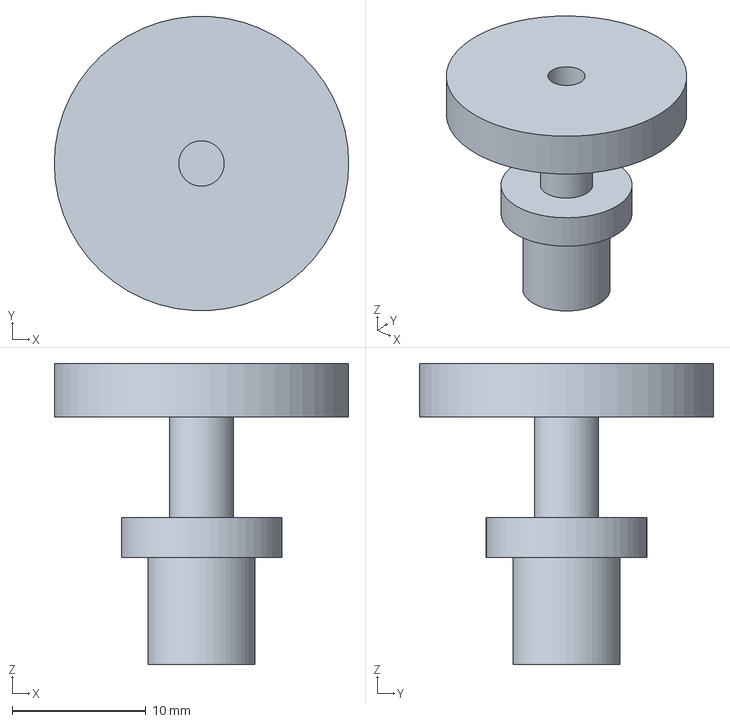
[picture p64: CAD file, 2026-10-12]
fabrication/printed/carrier-body.step
22.0 x 22.0 x 22.5 mm
