0xmeowmeow/braidbench/fabrication/experiments/tension/rod-clamp.step

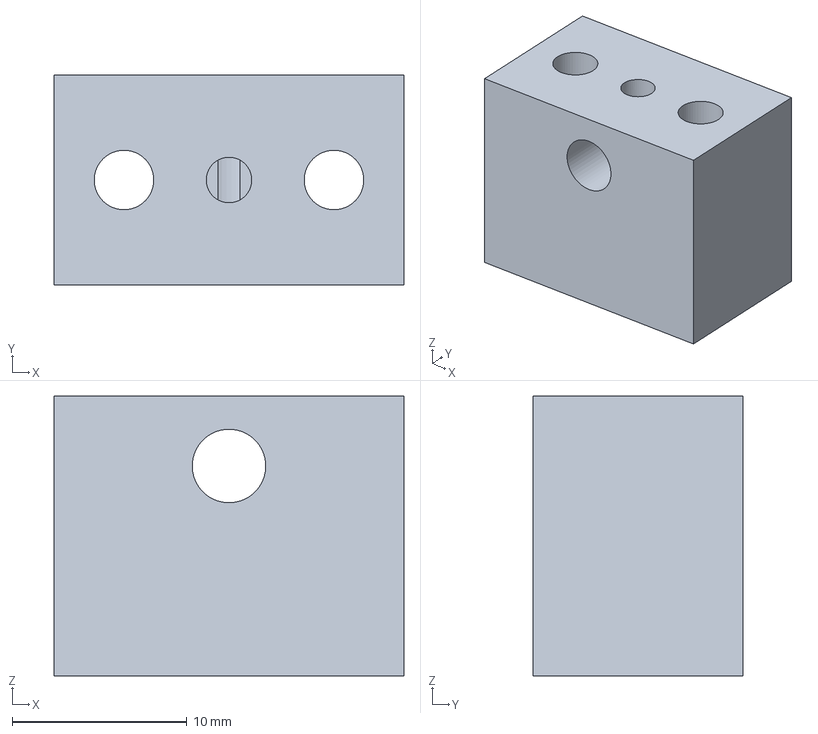
[picture p65: CAD file, 2026-10-12]
fabrication/experiments/tension/rod-clamp.step
20.0 x 12.0 x 16.0 mm
