0xmeowmeow/braidbench/fabrication/laser/track-study-16.dxf

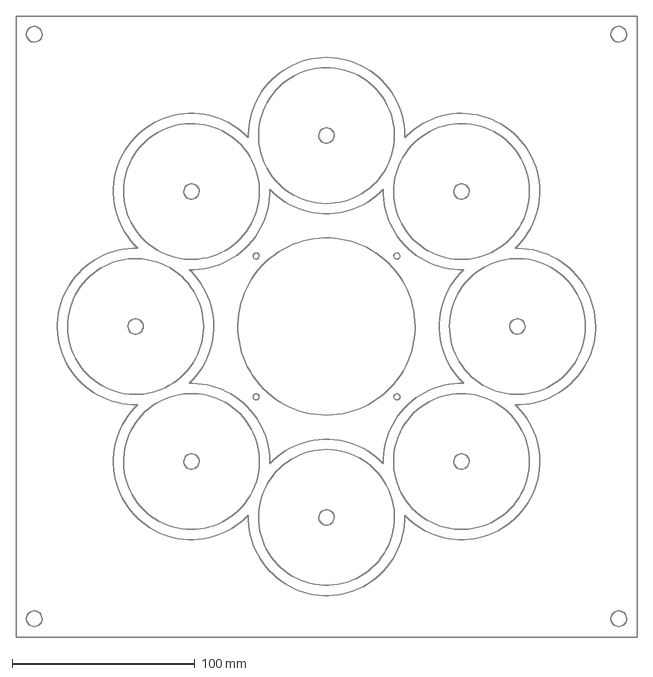
[picture p66: CAD file, 2026-10-12]
fabrication/laser/track-study-16.dxf
340.0 x 340.0 mm
