0xmeowmeow/braidbench/fabrication/experiments/tension/pulley-retainer.step

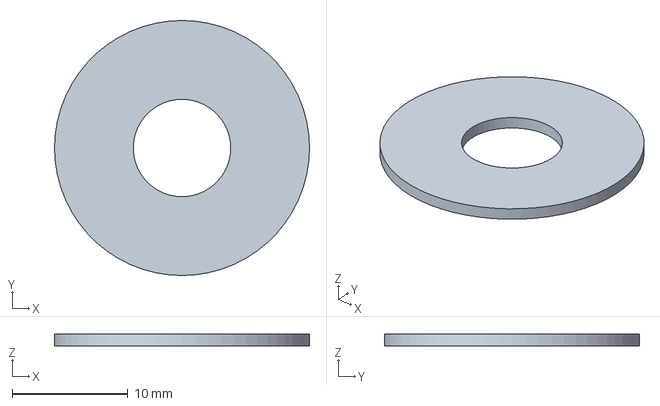
[picture p67: CAD file, 2026-10-12]
fabrication/experiments/tension/pulley-retainer.step
22.0 x 22.0 x 1.00 mm
