0xmeowmeow/braidbench/fabrication/laser/track-study-12.dxf

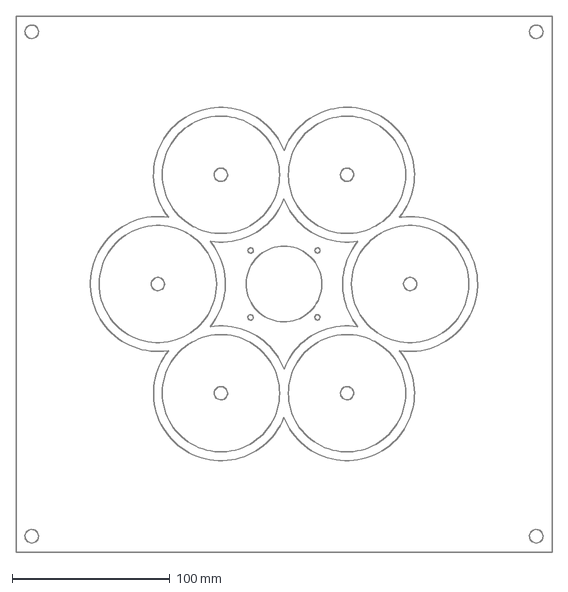
[picture p68: CAD file, 2026-10-12]
fabrication/laser/track-study-12.dxf
340.0 x 340.0 mm
