0xmeowmeow/braidbench/fabrication/printed/axle-spacer.step

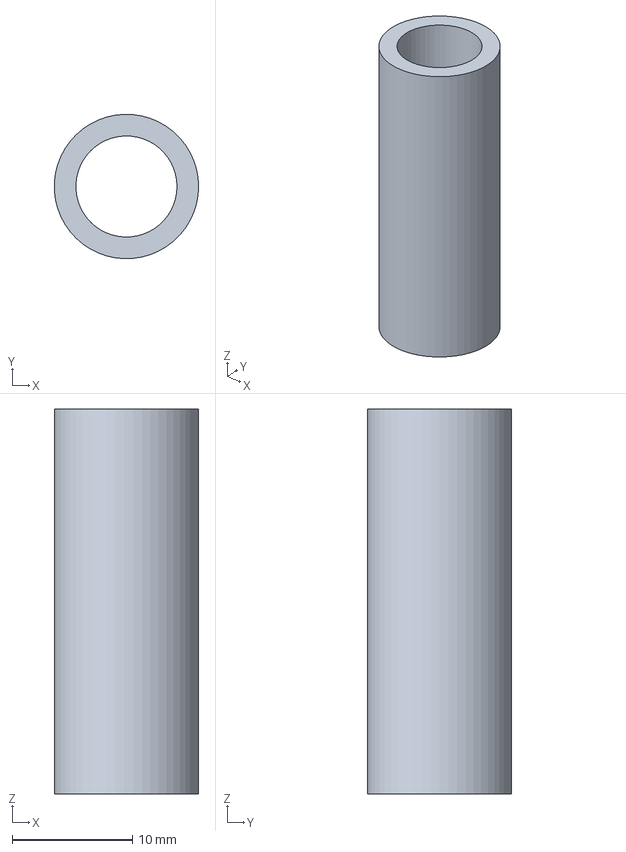
[picture p69: CAD file, 2026-10-12]
fabrication/printed/axle-spacer.step
12.0 x 12.0 x 32.0 mm
