0xmeowmeow/braidbench/fabrication/experiments/tension/guide-rod.step

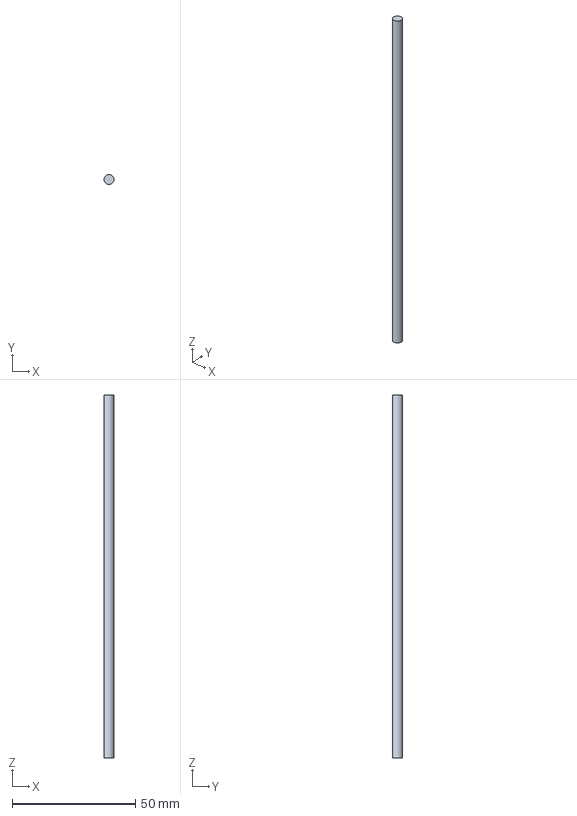
[picture p70: CAD file, 2026-10-12]
fabrication/experiments/tension/guide-rod.step
4.00 x 4.00 x 147.0 mm
