0xmeowmeow/braidbench/fabrication/laser/base-16.dxf

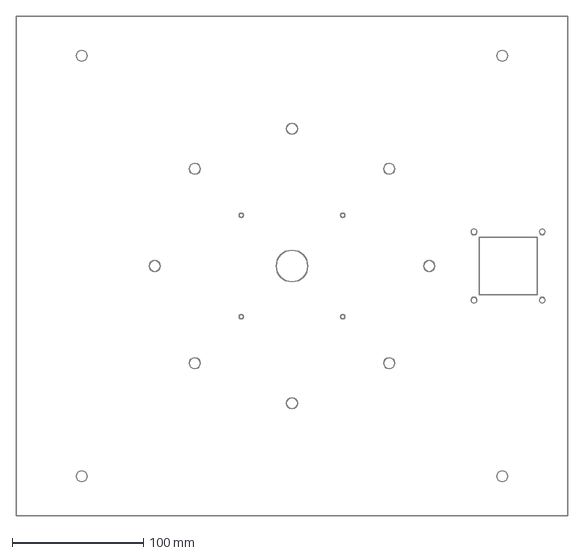
[picture p71: CAD file, 2026-10-12]
fabrication/laser/base-16.dxf
420.0 x 380.0 mm
