0xmeowmeow/braidbench/fabrication/experiments/tension/M3-moving-axle.step

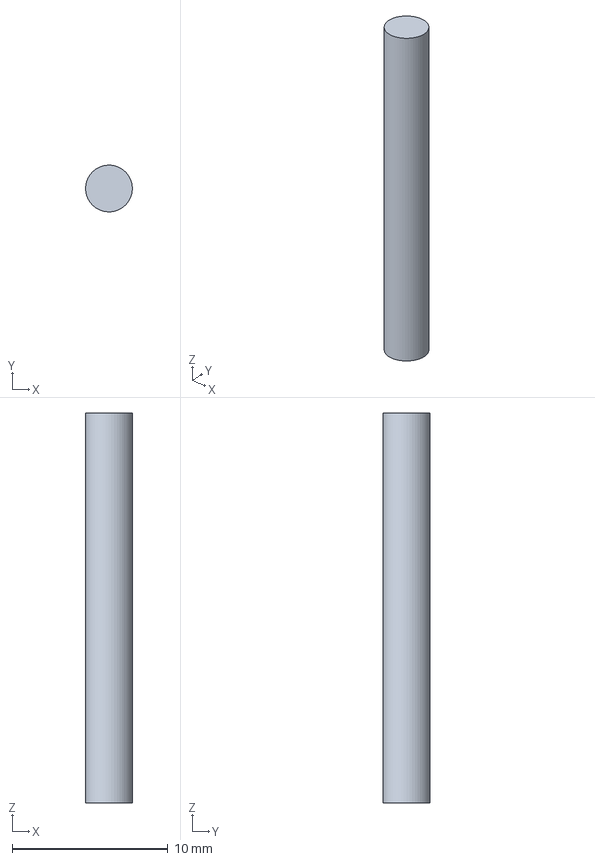
[picture p72: CAD file, 2026-10-12]
fabrication/experiments/tension/M3-moving-axle.step
3.00 x 3.00 x 25.0 mm
