0xmeowmeow/braidbench/fabrication/laser/takeup-bridge.dxf

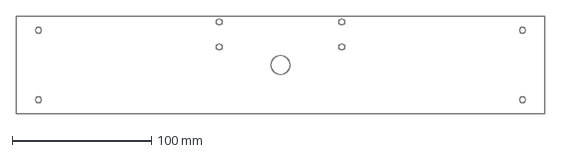
[picture p73: CAD file, 2026-10-12]
fabrication/laser/takeup-bridge.dxf
380.0 x 70.0 mm
