0xmeowmeow/braidbench/fabrication/experiments/tension/felt-brake.step

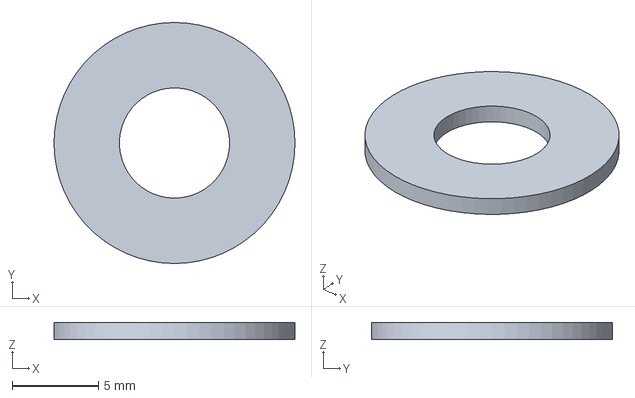
[picture p74: CAD file, 2026-10-12]
fabrication/experiments/tension/felt-brake.step
14.0 x 14.0 x 1.00 mm
