0xmeowmeow/braidbench/fabrication/experiments/tension/brake-spring.step

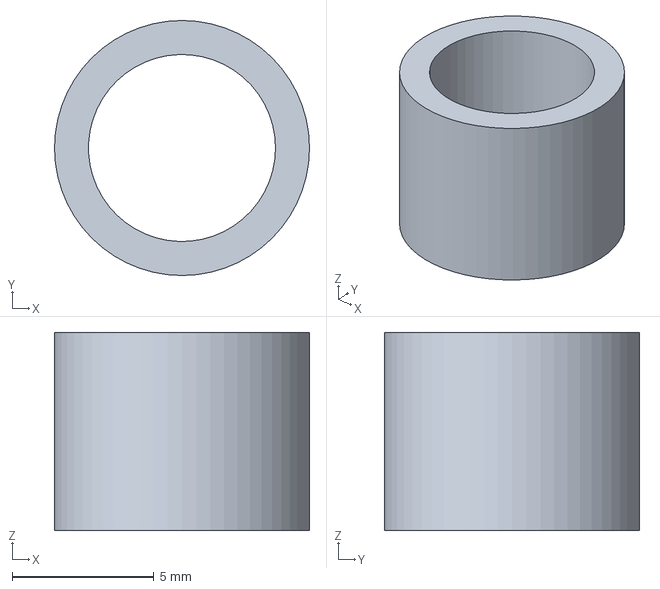
[picture p75: CAD file, 2026-10-12]
fabrication/experiments/tension/brake-spring.step
9.00 x 9.00 x 7.00 mm
