0xmeowmeow/braidbench/fabrication/experiments/tension/pulley.step

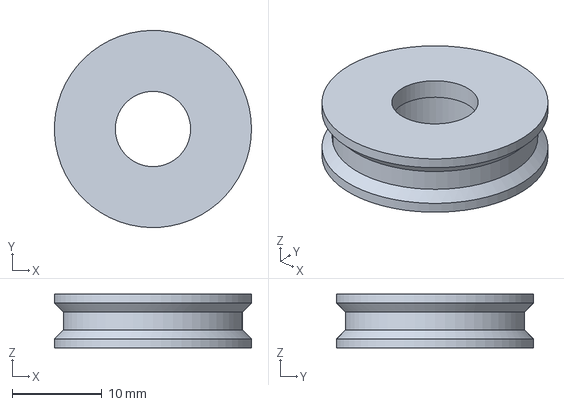
[picture p76: CAD file, 2026-10-12]
fabrication/experiments/tension/pulley.step
22.0 x 22.0 x 6.00 mm
