0xmeowmeow/braidbench/fabrication/printed/electronics-tray.step

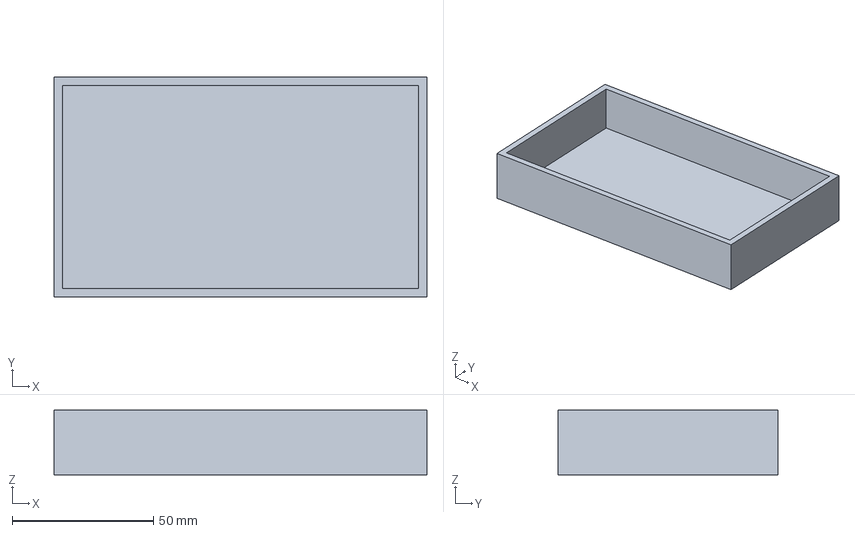
[picture p77: CAD file, 2026-10-12]
fabrication/printed/electronics-tray.step
132.0 x 78.0 x 23.0 mm
