0xmeowmeow/braidbench/fabrication/experiments/tension/dancer-slider.step

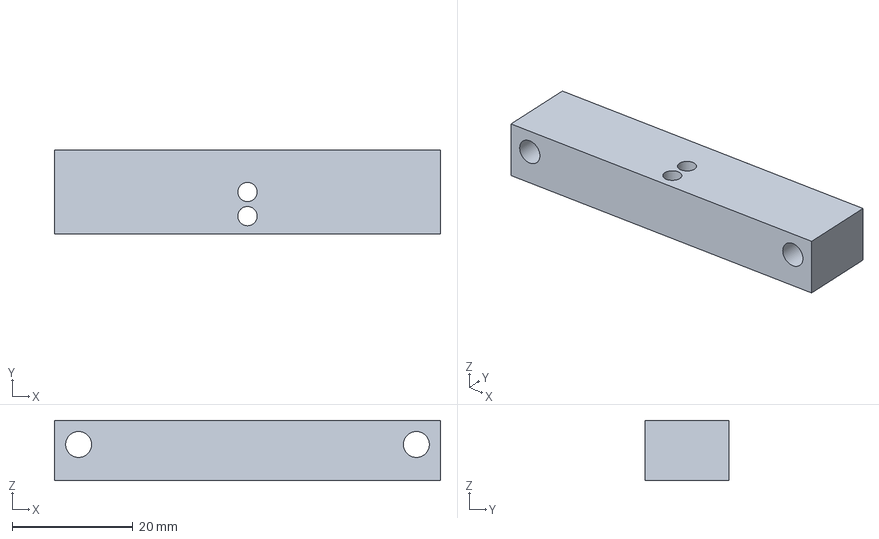
[picture p78: CAD file, 2026-10-12]
fabrication/experiments/tension/dancer-slider.step
64.0 x 14.0 x 10.0 mm
