0xmeowmeow/braidbench/fabrication/experiments/tension/fixed-axle-post.step

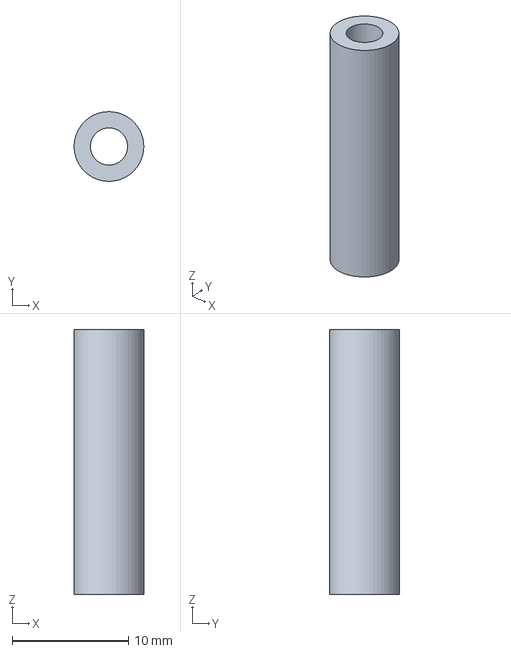
[picture p79: CAD file, 2026-10-12]
fabrication/experiments/tension/fixed-axle-post.step
5.99 x 6.00 x 22.8 mm
