0xmeowmeow/braidbench/fabrication/experiments/tension/623-bearing.step

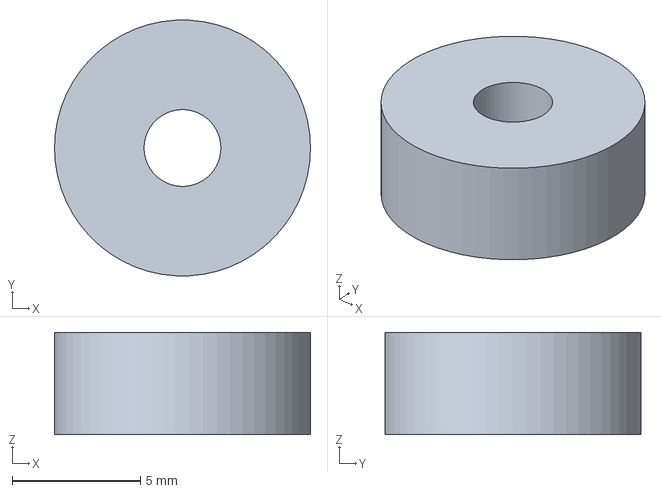
[picture p80: CAD file, 2026-10-12]
fabrication/experiments/tension/623-bearing.step
10.0 x 9.99 x 4.00 mm
