0xmeowmeow/braidbench/fabrication/experiments/tension/M6-spindle.step

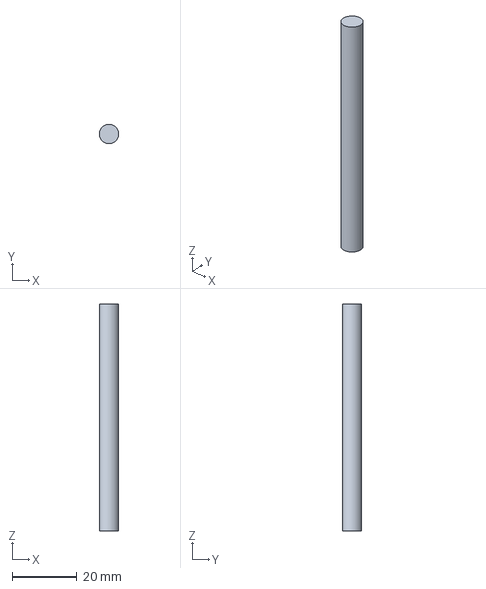
[picture p81: CAD file, 2026-10-12]
fabrication/experiments/tension/M6-spindle.step
5.99 x 6.00 x 70.0 mm
