0xmeowmeow/braidbench/fabrication/experiments/tension/guide-eye.step

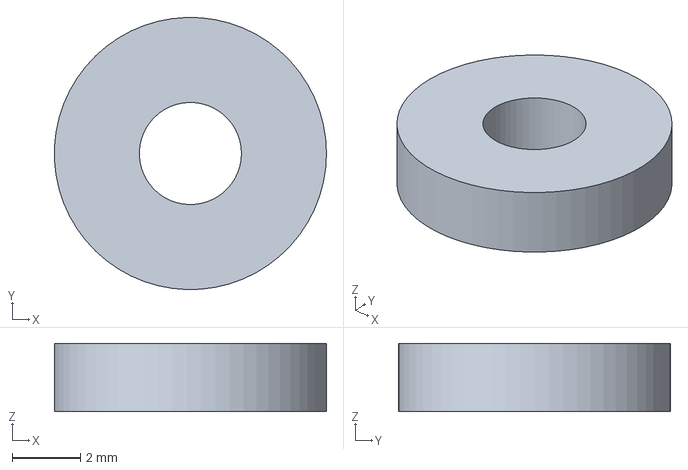
[picture p82: CAD file, 2026-10-12]
fabrication/experiments/tension/guide-eye.step
7.99 x 8.00 x 2.00 mm
