0xmeowmeow/braidbench/fabrication/experiments/tension/board.step

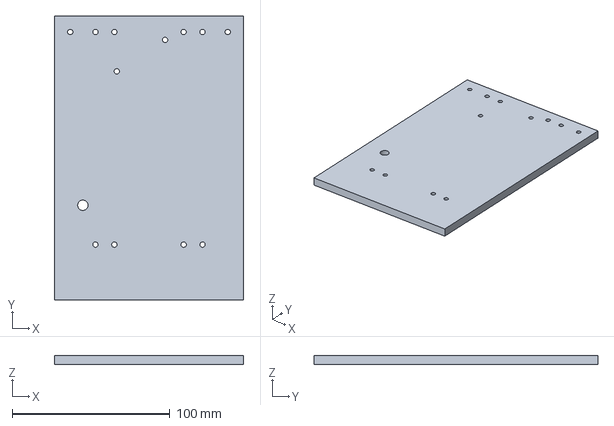
[picture p83: CAD file, 2026-10-12]
fabrication/experiments/tension/board.step
120.0 x 180.0 x 6.00 mm
