0xmeowmeow/braidbench/fabrication/experiments/tension/moving-axle-post.step

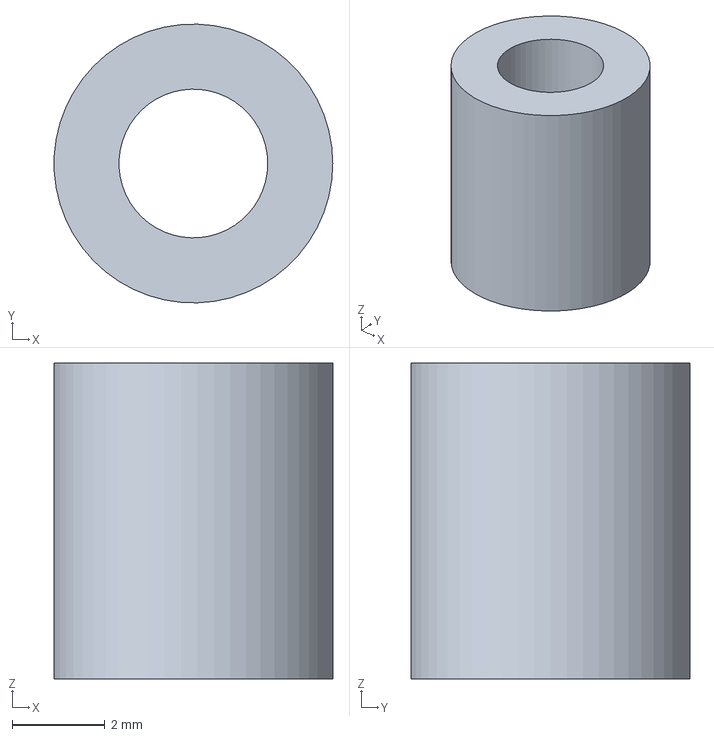
[picture p84: CAD file, 2026-10-12]
fabrication/experiments/tension/moving-axle-post.step
5.99 x 6.00 x 6.80 mm
