0xmeowmeow/braidbench/fabrication/printed/capstan.step

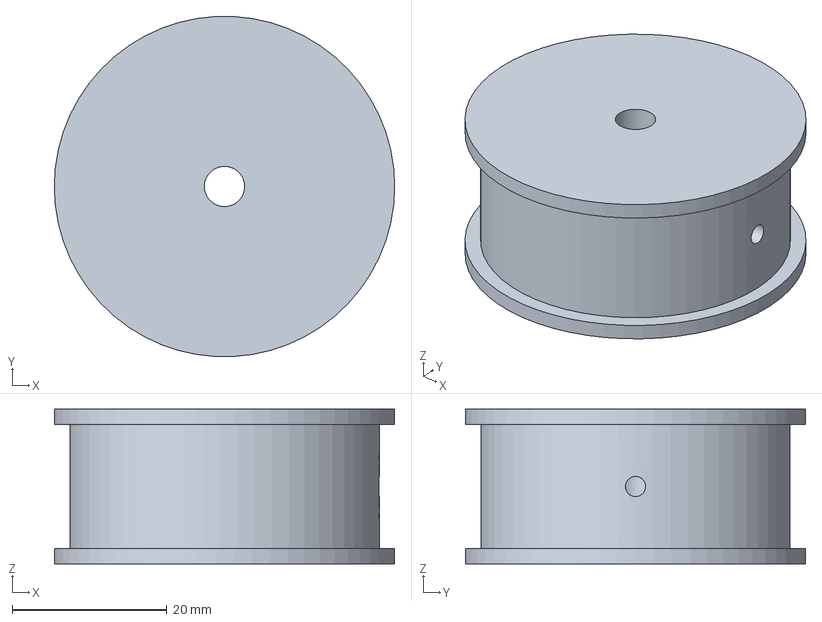
[picture p85: CAD file, 2026-10-12]
fabrication/printed/capstan.step
44.0 x 43.9 x 20.0 mm
