0xmeowmeow/braidbench/fabrication/printed/yarn-eye-post.step

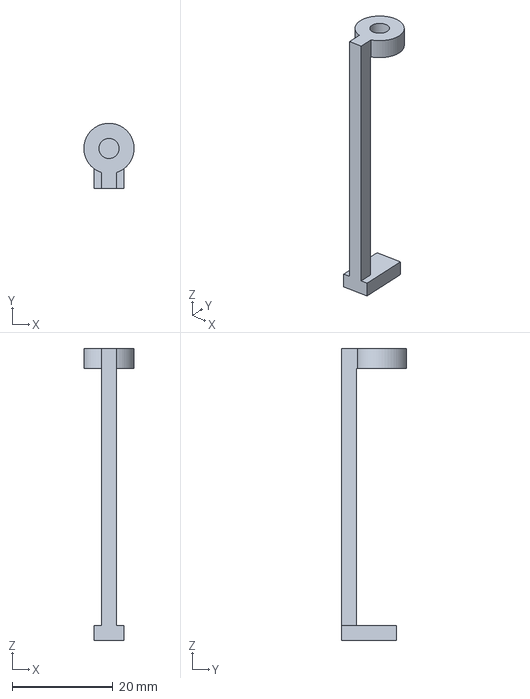
[picture p86: CAD file, 2026-10-12]
fabrication/printed/yarn-eye-post.step
10.00 x 13.0 x 58.0 mm
