0xmeowmeow/braidbench/fabrication/printed/idler.step

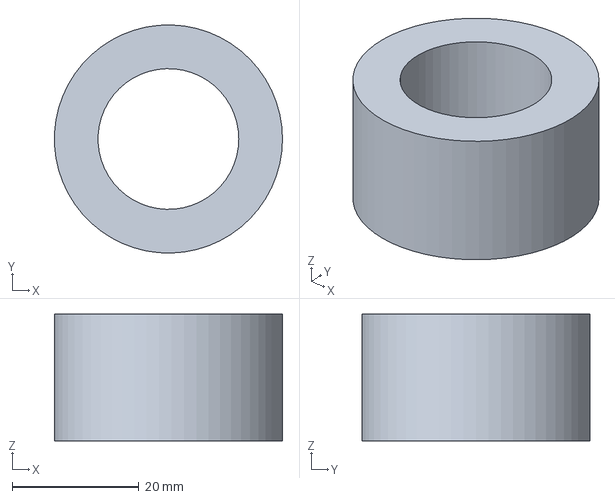
[picture p87: CAD file, 2026-10-12]
fabrication/printed/idler.step
36.0 x 36.0 x 20.0 mm
