0xmeowmeow/braidbench/fabrication/printed/yarn-guide-arm.step

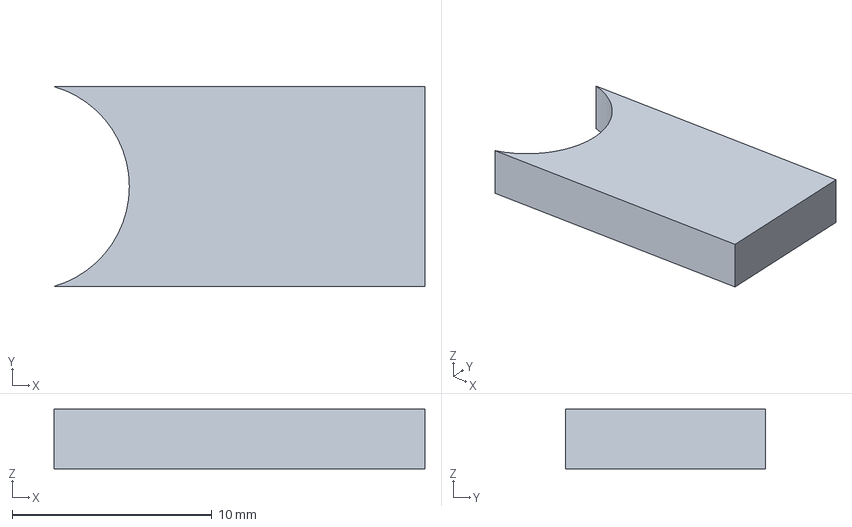
[picture p88: CAD file, 2026-10-12]
fabrication/printed/yarn-guide-arm.step
18.6 x 10.0 x 3.00 mm
