0xmeowmeow/braidbench/fabrication/printed/drive-pinion.step

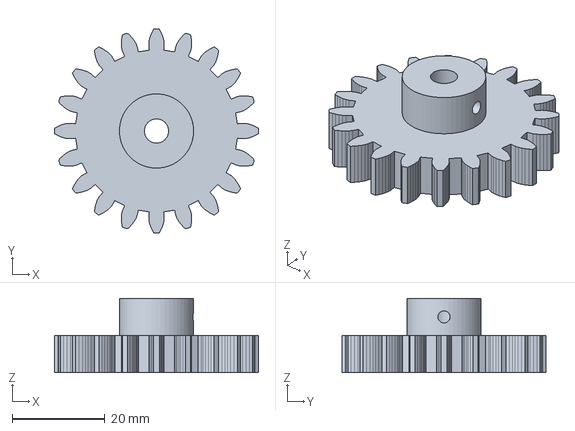
[picture p89: CAD file, 2026-10-12]
fabrication/printed/drive-pinion.step
44.0 x 44.0 x 16.0 mm
