0xmeowmeow/braidbench/(list of files, cad)

Other CAD files:
fabrication/printed/rotor-16-03.step
fabrication/printed/rotor-16-06.step
fabrication/printed/rotor-16-08.step
fabrication/printed/rotor-16-04.step
fabrication/printed/rotor-16-07.step
fabrication/printed/rotor-12-02.step
fabrication/printed/rotor-12-06.step
fabrication/printed/rotor-12-01.step
fabrication/printed/rotor-12-04.step
fabrication/printed/rotor-16-05.step
fabrication/printed/rotor-12-03.step
fabrication/printed/rotor-8-04.step
fabrication/printed/rotor-16-01.step
fabrication/printed/rotor-8-02.step
fabrication/printed/rotor-12-05.step
fabrication/printed/rotor-8-03.step
fabrication/printed/rotor-16-02.step
cad/braidbench-12.FCStd
cad/braidbench-16.FCStd
cad/braidbench-8.FCStd
fabrication/experiments/tension/M6-nut.step
fabrication/experiments/tension/axle-washer.step
fabrication/experiments/tension/bench-bobbin.stl
fabrication/experiments/tension/board.dxf
fabrication/experiments/tension/bobbin-base.stl
fabrication/experiments/tension/dancer-slider.stl
fabrication/experiments/tension/eye-holder.stl
fabrication/experiments/tension/fixed-axle-post.stl
fabrication/experiments/tension/moving-axle-post.stl
fabrication/experiments/tension/pulley-retainer.stl
fabrication/experiments/tension/pulley.stl
fabrication/experiments/tension/rod-clamp.stl
fabrication/experiments/tension/tension-board.FCStd
fabrication/experiments/transfer/base.dxf
fabrication/experiments/transfer/boat-shoe.stl
fabrication/experiments/transfer/cover.dxf
fabrication/experiments/transfer/handle.stl
fabrication/experiments/transfer/round-shoe.stl
fabrication/experiments/transfer/track.dxf
fabrication/experiments/transfer/transfer-coupon.FCStd
fabrication/printed/axle-spacer.stl
fabrication/printed/bobbin.stl
fabrication/printed/capstan.stl
fabrication/printed/carrier-body.stl
fabrication/printed/drive-pinion.stl
fabrication/printed/electronics-tray.stl
fabrication/printed/foot.stl
fabrication/printed/idler.stl
fabrication/printed/rotor-12-01.stl
fabrication/printed/rotor-12-02.stl
fabrication/printed/rotor-12-03.stl
fabrication/printed/rotor-12-04.stl
fabrication/printed/rotor-12-05.stl
fabrication/printed/rotor-12-06.stl
fabrication/printed/rotor-16-01.stl
fabrication/printed/rotor-16-02.stl
fabrication/printed/rotor-16-03.stl
fabrication/printed/rotor-16-04.stl
fabrication/printed/rotor-16-05.stl
fabrication/printed/rotor-16-06.stl
fabrication/printed/rotor-16-07.stl
fabrication/printed/rotor-16-08.stl
fabrication/printed/rotor-8-01.stl
fabrication/printed/rotor-8-02.stl
fabrication/printed/rotor-8-03.stl
fabrication/printed/rotor-8-04.stl
fabrication/printed/spindle-adapter.stl
fabrication/printed/yarn-eye-post.stl
fabrication/printed/yarn-guide-arm.stl
