0xmeowmeow/braidbench/previews/assembled.png

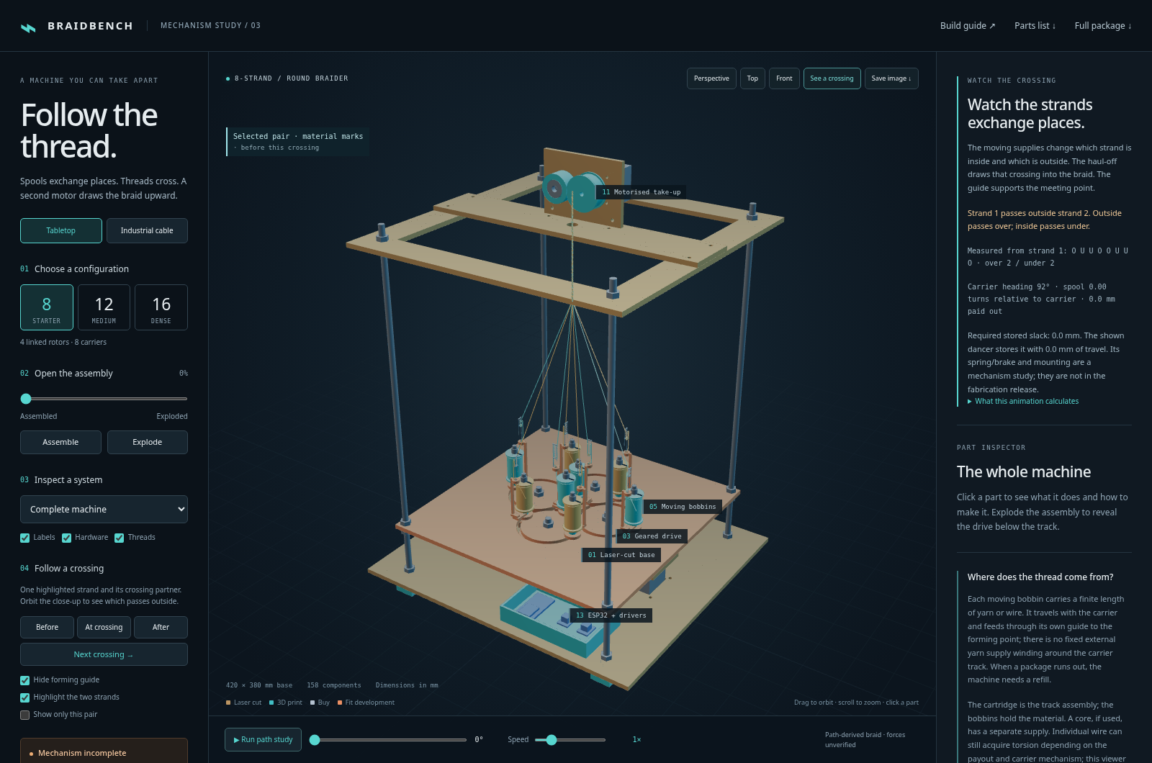
previews/assembled.png
