0xmeowmeow/braidbench/(commit log)

2026-10-12 Add verified braid geometry viewer and prototype design package
    [axle-spacer.step, axle-spacer.stl, base-12.dxf, base-16.dxf, base-8.dxf, bobbin.step, bobbin.stl, braidbench-12.FCStd]
2026-10-12 Add contact-tested carrier coupon and tension calibration bench
    [623-bearing.step, M3-fixed-axle.step, M3-moving-axle.step, M6-nut.step, M6-spindle.step, axle-washer.step, base.dxf, base.step]
